CHOMPI-Club/CHOMPI/hardware/hardware-enclosure/README.md

# CHOMPI — Enclosure Panels

The six PCB files for **CHOMPI**'s enclosure panels — plus laser cutting files if you want to
create your own enclosure boards from alternative materials (wood, acrylic, etc.).

---

## What's in the folder

```
CC_Chompi_Rev4_Enc_TOP.brd
CC_Chompi_Rev4_Enc_BOT.brd
CC_Chompi_Rev4_Enc_FRONT.brd
CC_Chompi_Rev4_Enc_BACK.brd
CC_Chompi_Rev4_Enc_LEFT.brd
CC_Chompi_Rev4_Enc_RIGHT.brd
dxf/ each panel's outline and holes, formatted for a laser cutter
```

The `.brd` files are **EAGLE 9.6.2** and contain the outline, the holes, and a plain
copper fill on each side (with graphics removed). They are intended for use with the Rev4 main boards, 
and should be ordered as bare boards with no electrical assembly.

## What's not included

**The panel artwork.** The graphic set and CHOMPI logos have been removed for copyright
purposes, and the panel fabrication files aren't included. If you make your own panels,
we ask that you create new artwork and name your instrument something else to avoid
trademark infringement.

## Support Guidelines

This is a discontinuation open-source release. As such, this repo is intended to be a permanent
source for files and documentation, and will likely not be receiving updates in the future. If you wish
to customize your own project, we recommend cloning this repo into your own GitHub.

## Community

Even though this version of CHOMPI is now discontinued, the CLUB is expanding. If you want to
discuss this project, share your creations, see what other users have made on their CHOMPI, feel
free to check out the CHOMPI Open Source channel on the Chase Bliss Discord.

## License

MIT — see [`LICENSE`](../../LICENSE) at the root of this repo. [`THIRD_PARTY.md`](../../THIRD_PARTY.md)
lists the work this builds on. The CHOMPI name and marks are not covered by the license — see
[`TRADEMARKS.md`](../../TRADEMARKS.md).
