CHOMPI-Club/CHOMPI/firmware/chompi-tape/code/Chompi_Bootloader/bootloader/README.md

# bootloader

## Author

<!-- Insert Your Name Here -->

## Description

<!-- Describe your example here -->
