CHOMPI-Club/CHOMPI/hardware/hardware-enclosure/dxf/CC_Chompi_Rev4_Enc_BACK.dxf

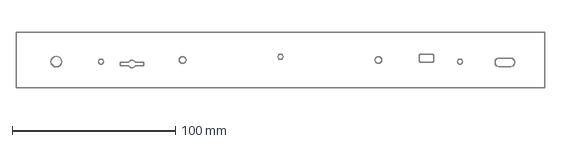
[picture p2: CAD file, 2026-09-29]
hardware/hardware-enclosure/dxf/CC_Chompi_Rev4_Enc_BACK.dxf
324.0 x 34.2 mm
