CHOMPI-Club/CHOMPI/hardware/hardware-enclosure/dxf/CC_Chompi_Rev4_Enc_LEFT.dxf

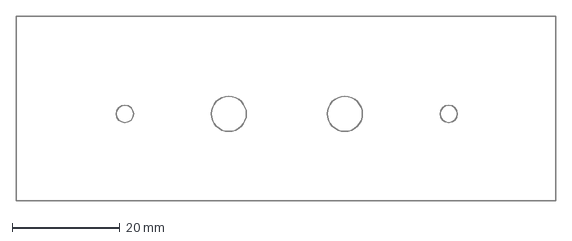
[picture p3: CAD file, 2026-09-29]
hardware/hardware-enclosure/dxf/CC_Chompi_Rev4_Enc_LEFT.dxf
100.0 x 34.2 mm
