CHOMPI-Club/CHOMPI/hardware/hardware-enclosure/dxf/CC_Chompi_Rev4_Enc_TOP.dxf

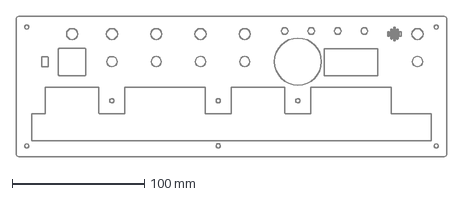
[picture p4: CAD file, 2026-09-29]
hardware/hardware-enclosure/dxf/CC_Chompi_Rev4_Enc_TOP.dxf
326.0 x 106.0 mm
