CHOMPI-Club/CHOMPI/hardware/hardware-enclosure/dxf/CC_Chompi_Rev4_Enc_FRONT.dxf

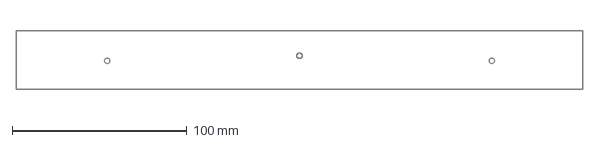
[picture p5: CAD file, 2026-09-29]
hardware/hardware-enclosure/dxf/CC_Chompi_Rev4_Enc_FRONT.dxf
324.0 x 33.2 mm
