CHOMPI-Club/CHOMPI/hardware/hardware-pcb/CHOMPI_Rev4_Schematic.pdf

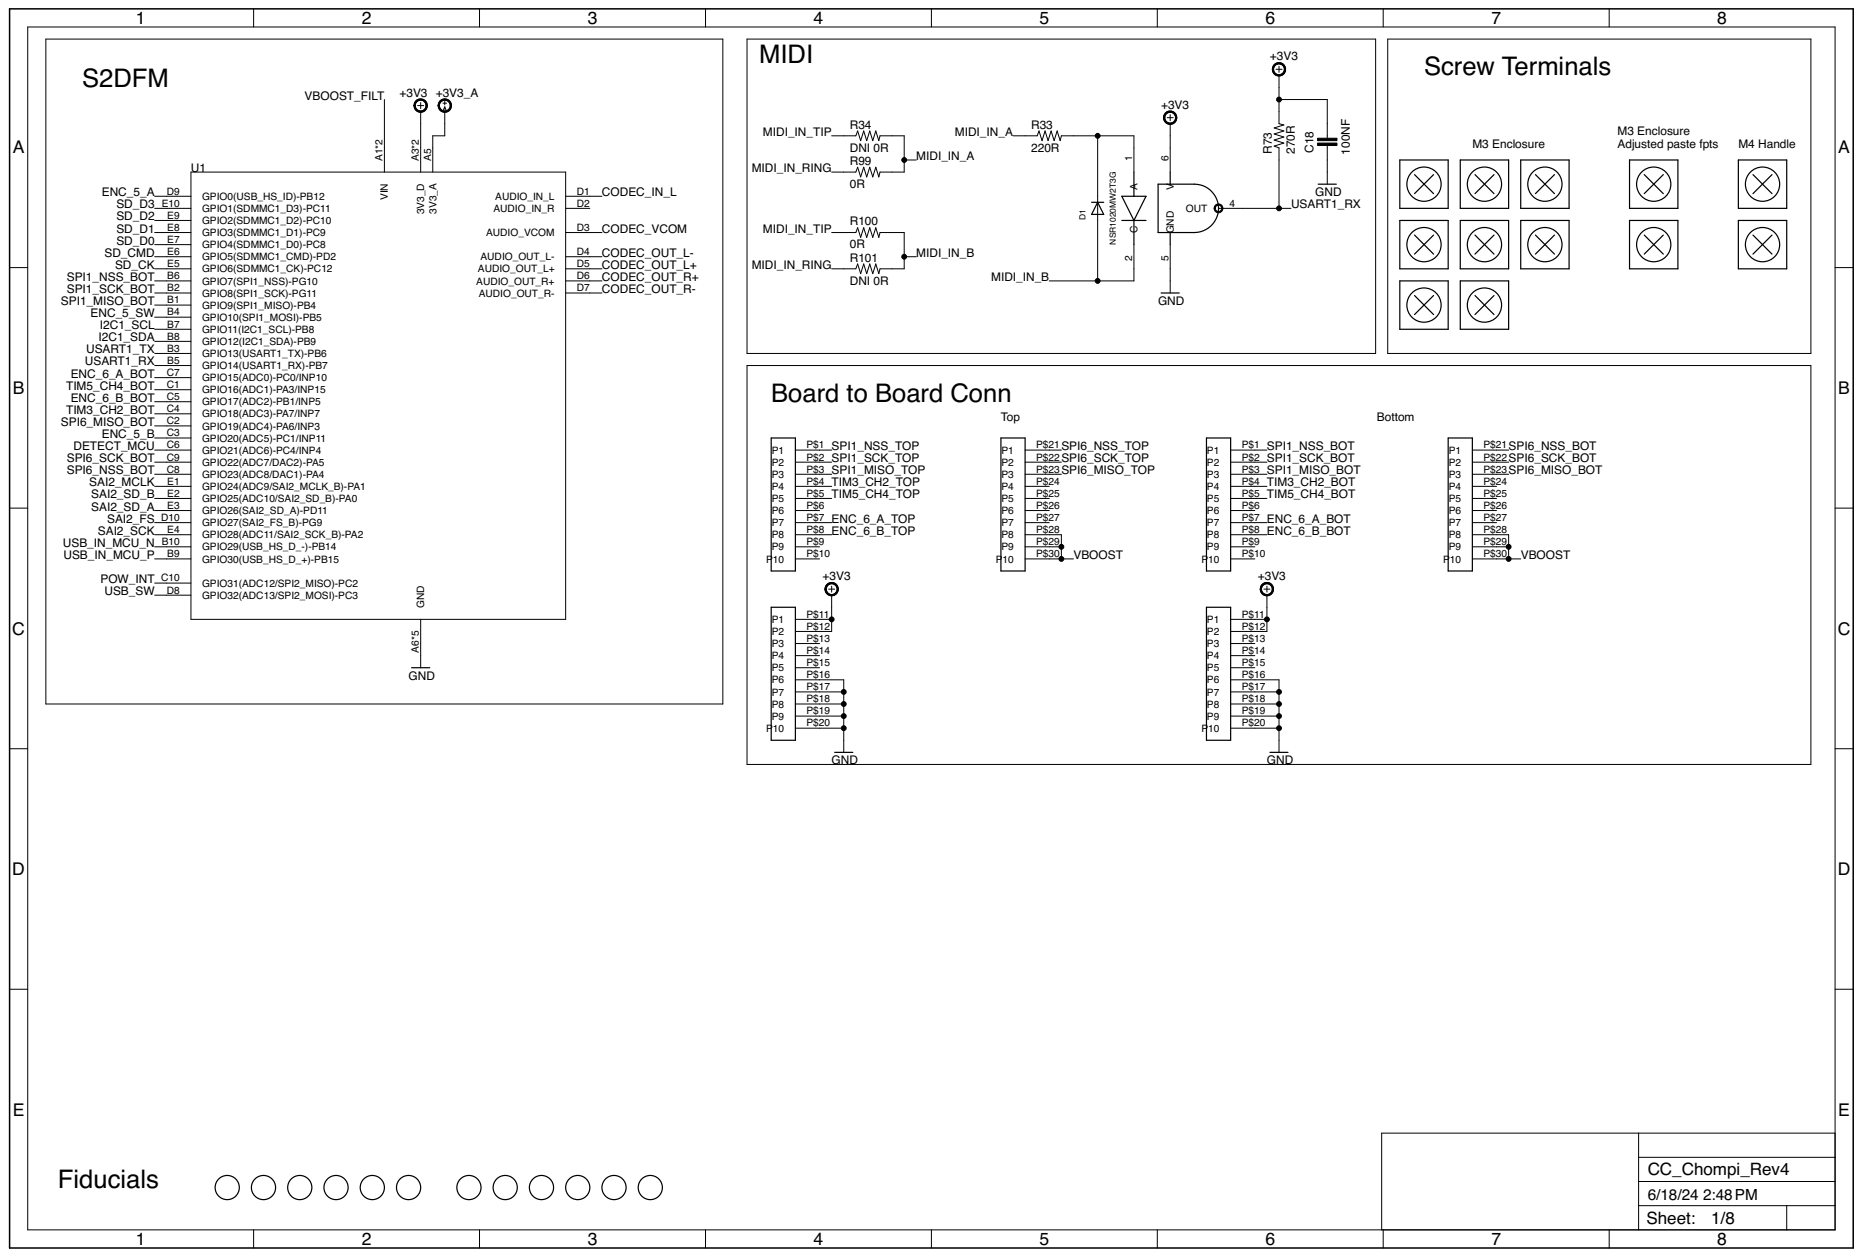
[picture p7: page 1]

Board to Board Conn

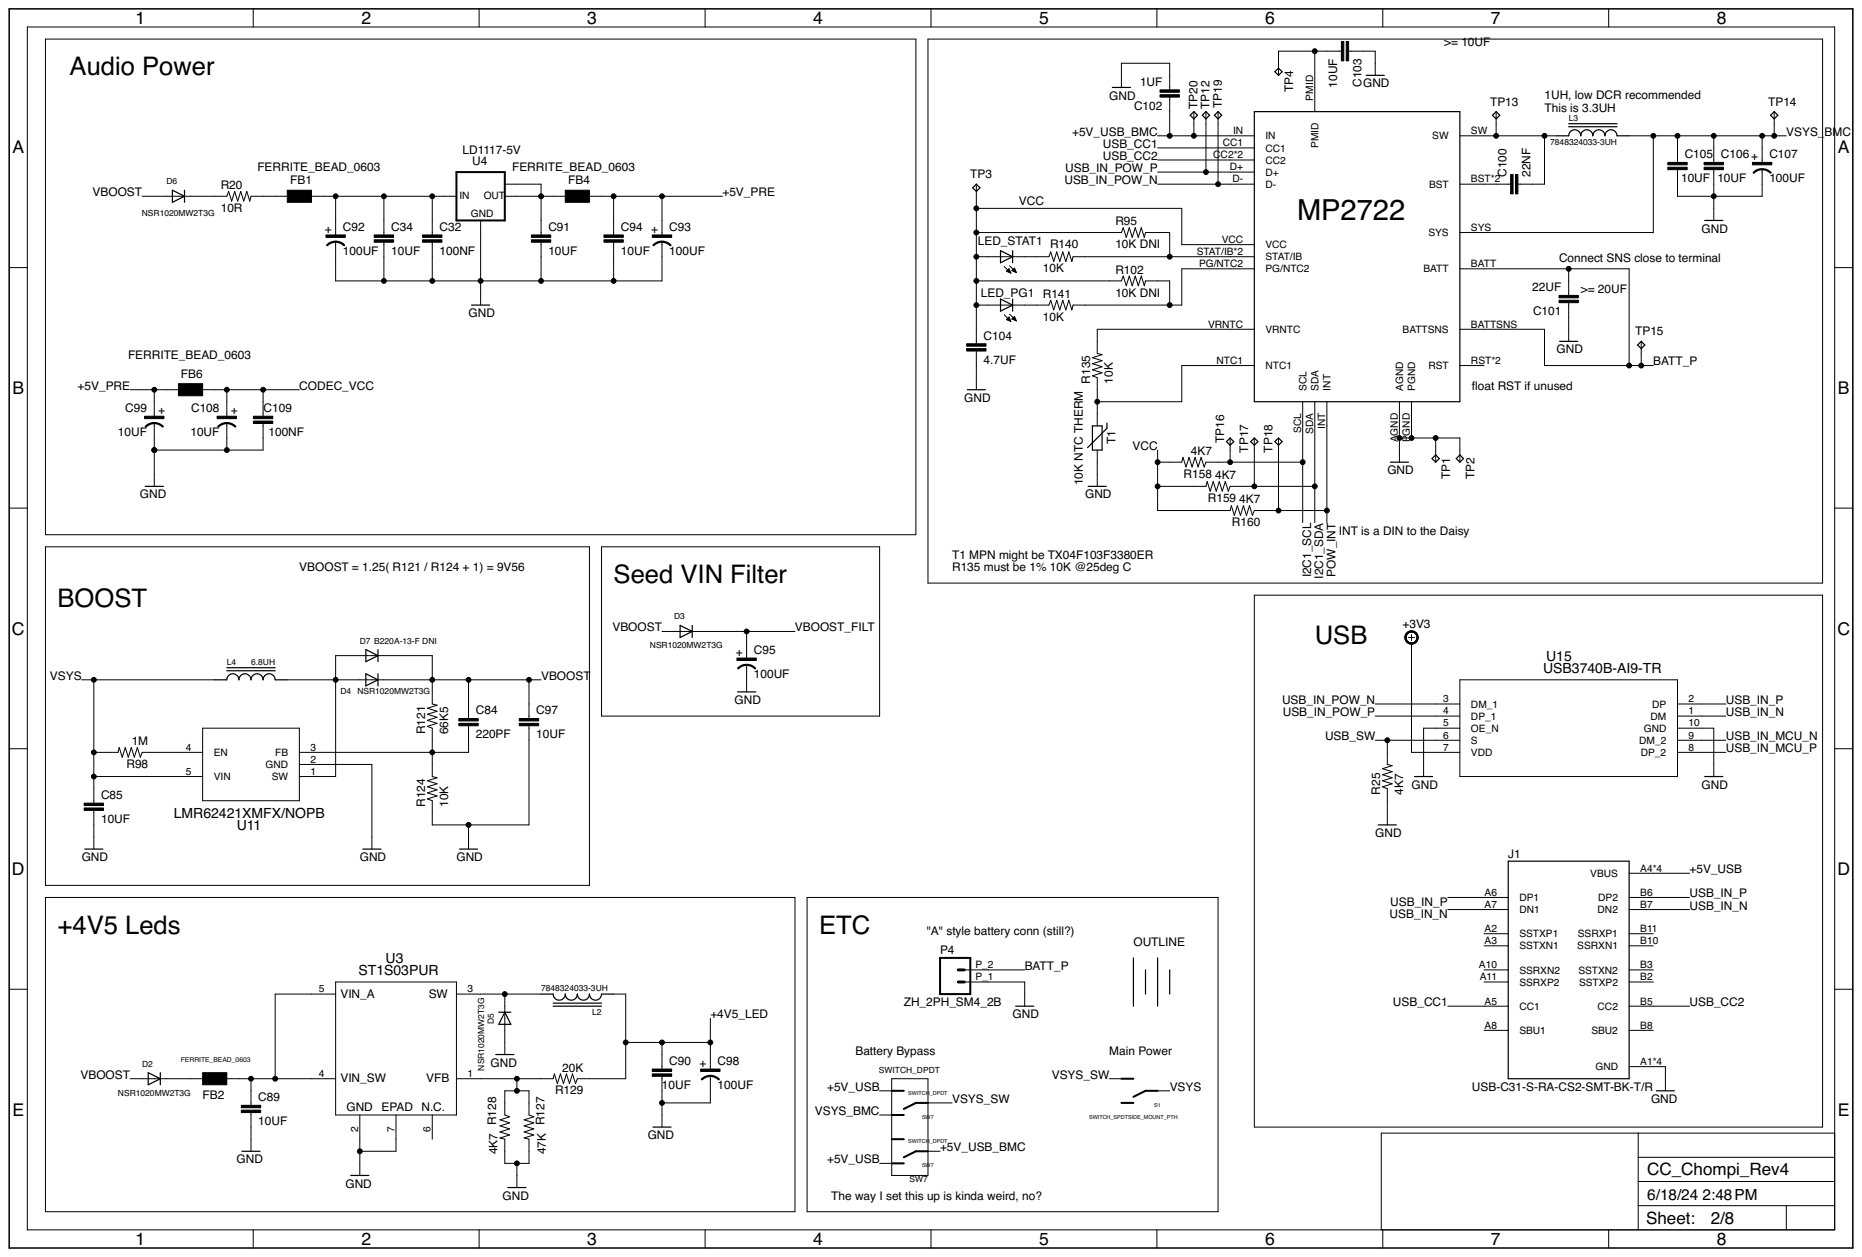
[picture p8: page 2]

Connect SNS close to terminal >= 20UF

float RST if unused

I2C1_SDA
INT is a DIN to the Daisy

"A" style battery conn (still?)

USB-C31-S-RA-CS2-SMT-BK-T/R

The way I set this up is kinda weird, no?

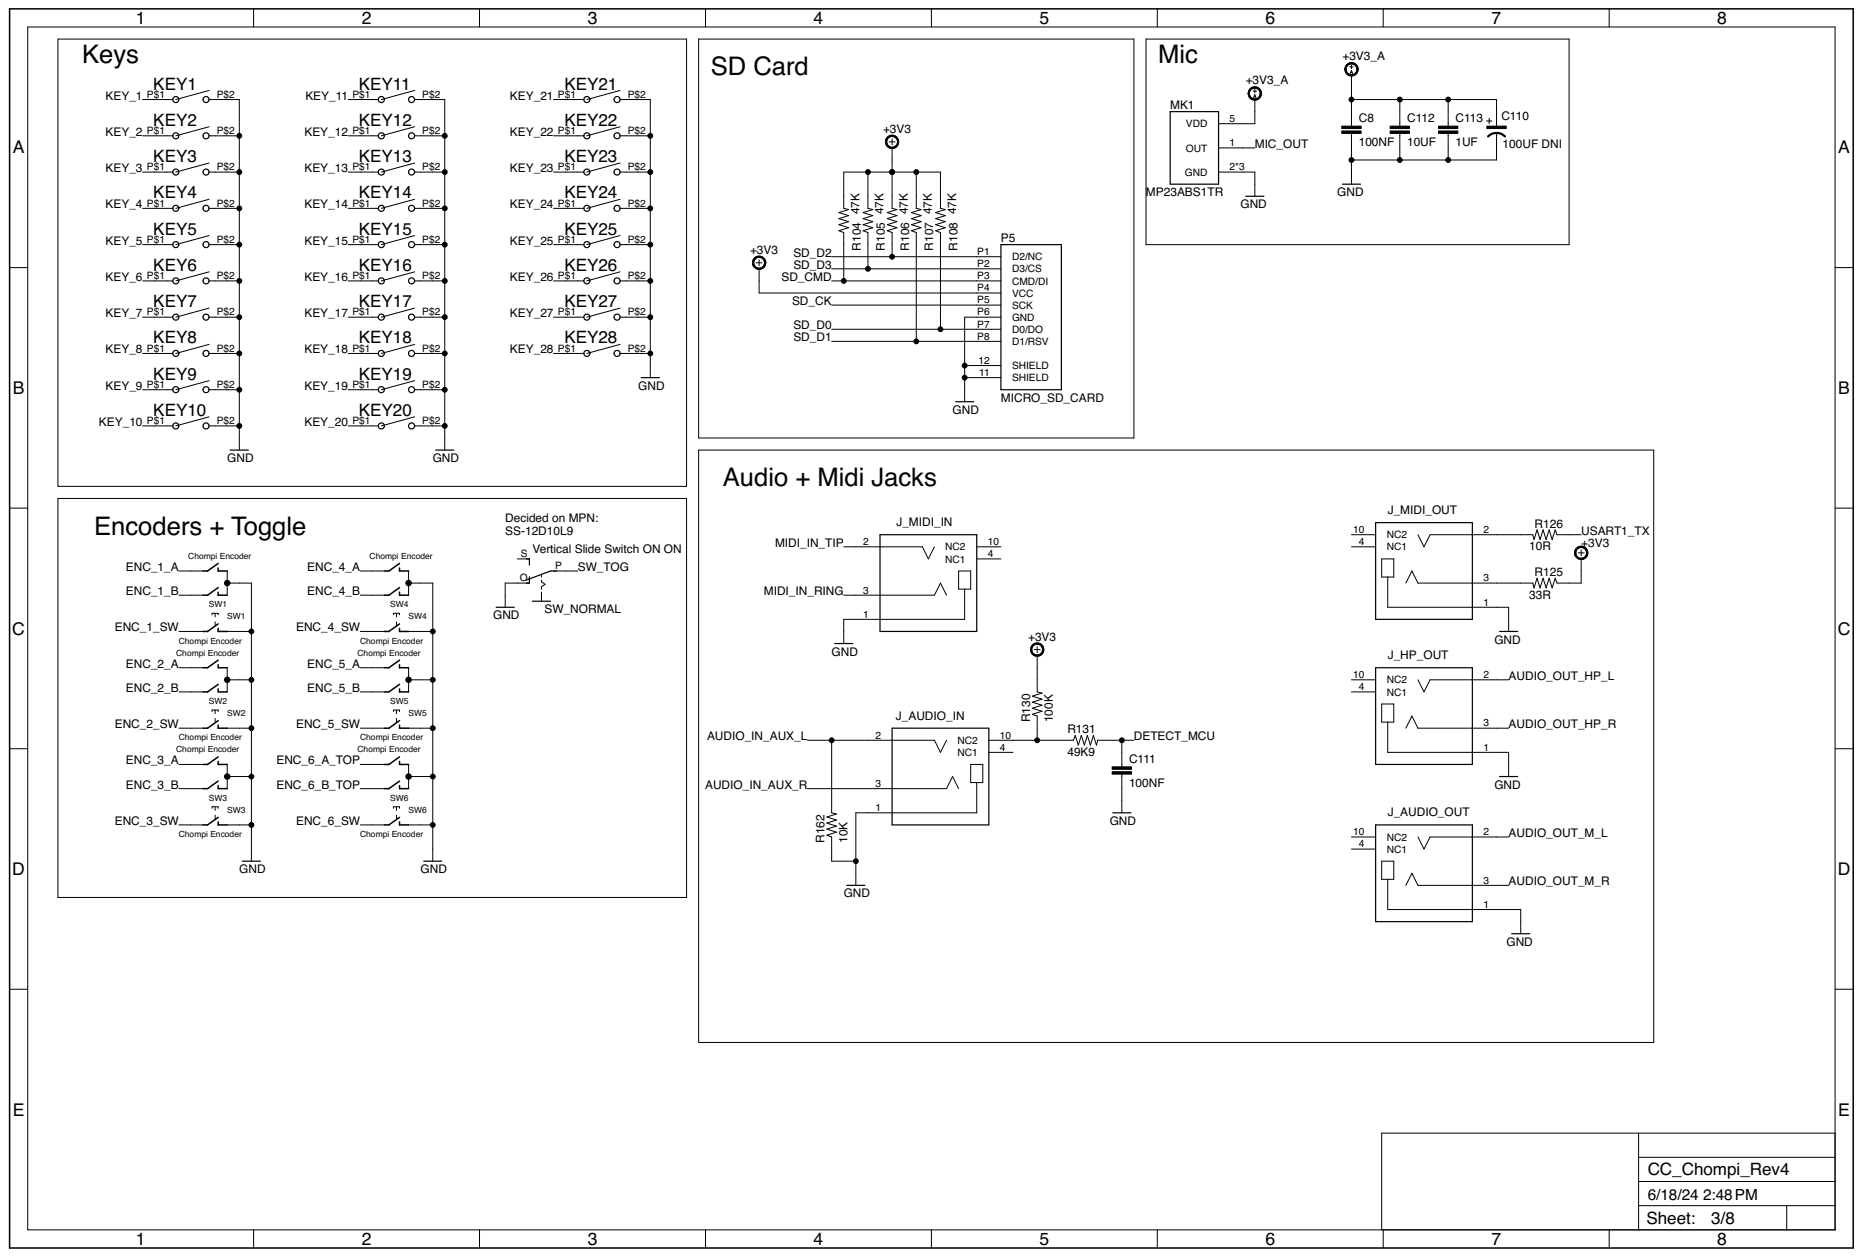
[picture p9: page 3]

Decided on MPN: SS-12D10L9

Vertical Slide Switch ON ON

Chompi Encoder

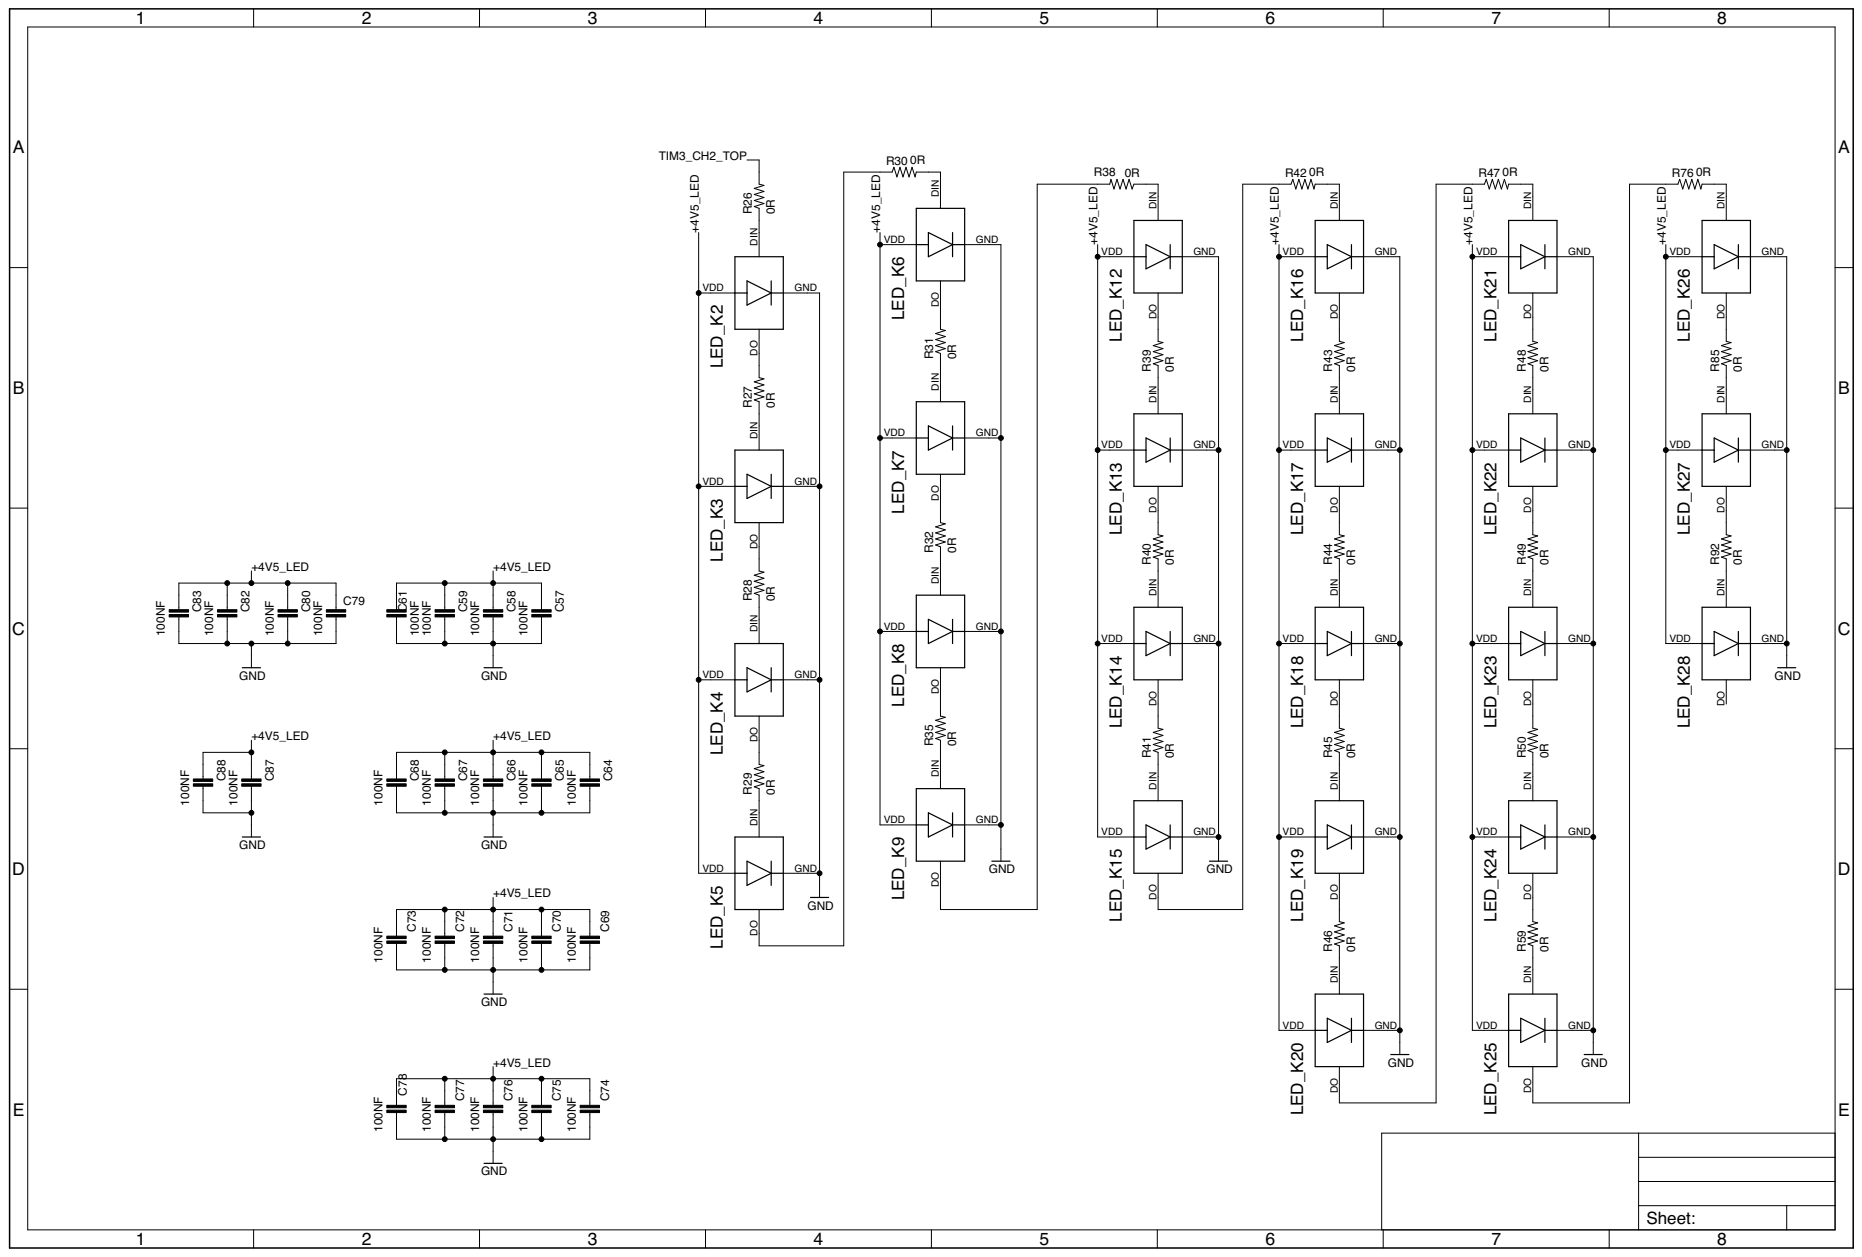
[picture p10: page 4]

LED_K2 LED_K4 LED_K5 LED_K3 GND 0R 0R 0R 0R LED_K6 LED_K7 LED_K8 LED_K9 GND 0R 0R 0R 0R LED_K12 LED_K13 LED_K14 LED_K15 GND 0R 0R 0R 0R LED_K16 LED_K17 LED_K18 LED_K19 LED_K20 GND 0R 0R 0R 0R 0R LED_K21 LED_K22 LED_K23 LED_K24 LED_K25 GND 0R 0R 0R 0R 0R LED_K26 LED_K27 LED_K28 GND 0R 0R 0R 100NF 100NF 100NF 100NF GND 100NF 100NF 100NF 100NF 100NF GND 100NF 100NF 100NF 100NF 100NF GND 100NF 100NF 100NF 100NF 100NF GND 100NF 100NF 100NF 100NF GND 100NF 100NF GND DIN DO VDD GND DIN DO VDD GND DIN DO VDD GND DIN DO VDD GND R26 R27 R28 R29 DIN DO VDD GND DIN DO VDD GND DIN DO VDD GND DIN DO VDD GND R30 R31 R32 R35 DIN DO VDD GND DIN DO VDD GND DIN DO VDD GND DIN DO VDD GND R38 R39 R40 R41 DIN DO VDD GND DIN DO VDD GND DIN DO VDD GND DIN DO VDD GND DIN DO VDD GND R42 R43 R44 R45 R46 DIN DO VDD GND DIN DO VDD GND DIN DO VDD GND DIN DO VDD GND DIN DO VDD GND R47 R48 R49 R50 R59 DIN DO VDD GND DIN DO VDD GND DIN DO VDD GND R76 R85 R92 C57 C58 C59 C61 C64 C65 C66 C67 C68 C69 C70 C71 C72 C73 C74 C75 C76 C77 C78 C79 C80 C82 C83 C87 C88 +4V5_LED +4V5_LED +4V5_LED +4V5_LED +4V5_LED +4V5_LED +4V5_LED +4V5_LED +4V5_LED +4V5_LED +4V5_LED +4V5_LED TIM3_CH2_TOP Sheet: ABCDE 1 2 3 4 5 6 7 8 ABCDE 1 2 3 4 5 6 7 8

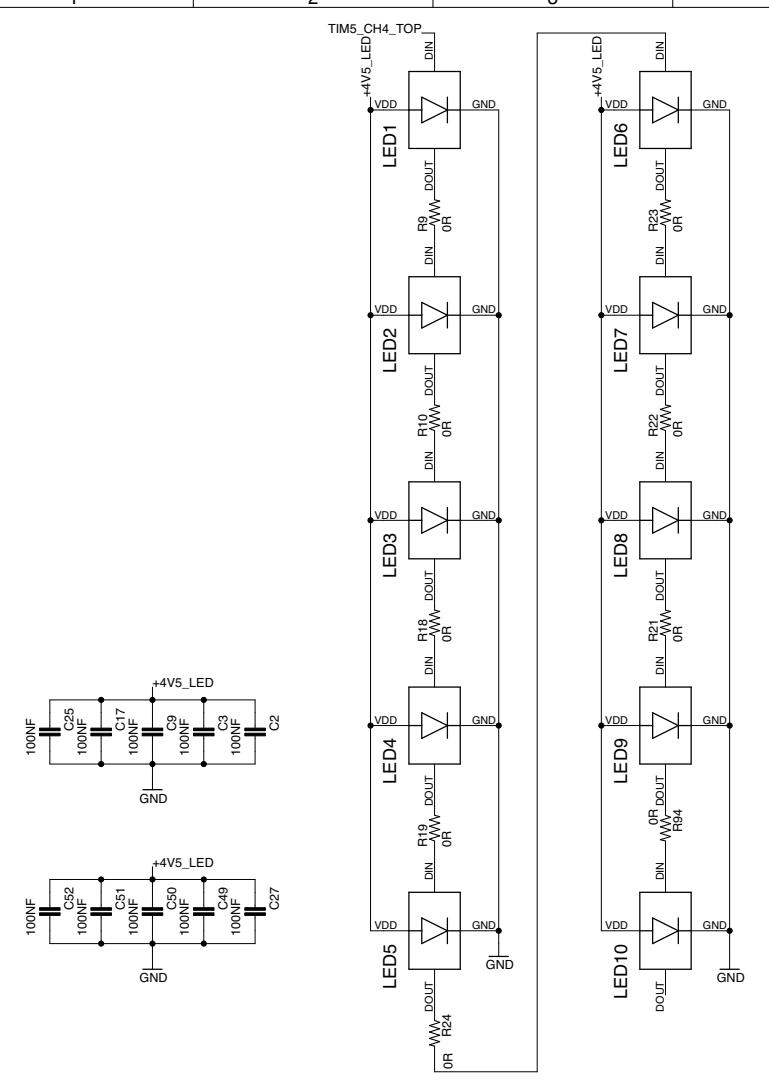
[picture p11: page 5]

LED1 LED2 LED3 LED4 LED5 LED6 LED7 LED8 LED9 LED10 GND 0R 0R 0R 0R 0R 0R 0R 0R 100NF 100NF 100NF 100NF 100NF GND 100NF 100NF 100NF 100NF 100NF GND 0R GND DIN DOUT VDD GND DIN DOUT VDD GND DIN DOUT VDD GND DIN DOUT VDD GND DIN DOUT VDD GND DIN DOUT VDD GND DIN DOUT VDD GND DIN DOUT VDD GND DIN DOUT VDD GND DIN DOUT VDD GND R9 R10 R18 R19 R21 R22 R23 R24 C2 C3 C9 C17 C25 C27 C49 C50 C51 C52 R94 +4V5_LED +4V5_LED +4V5_LED +4V5_LED TIM5_CH4_TOP Sheet: ABCDE 1 2 3 4 5 6 7 8 ABCDE 1 2 3 4 5 6 7 8 CC_Chompi_Rev4 6/18/24 2:48PM 5/8

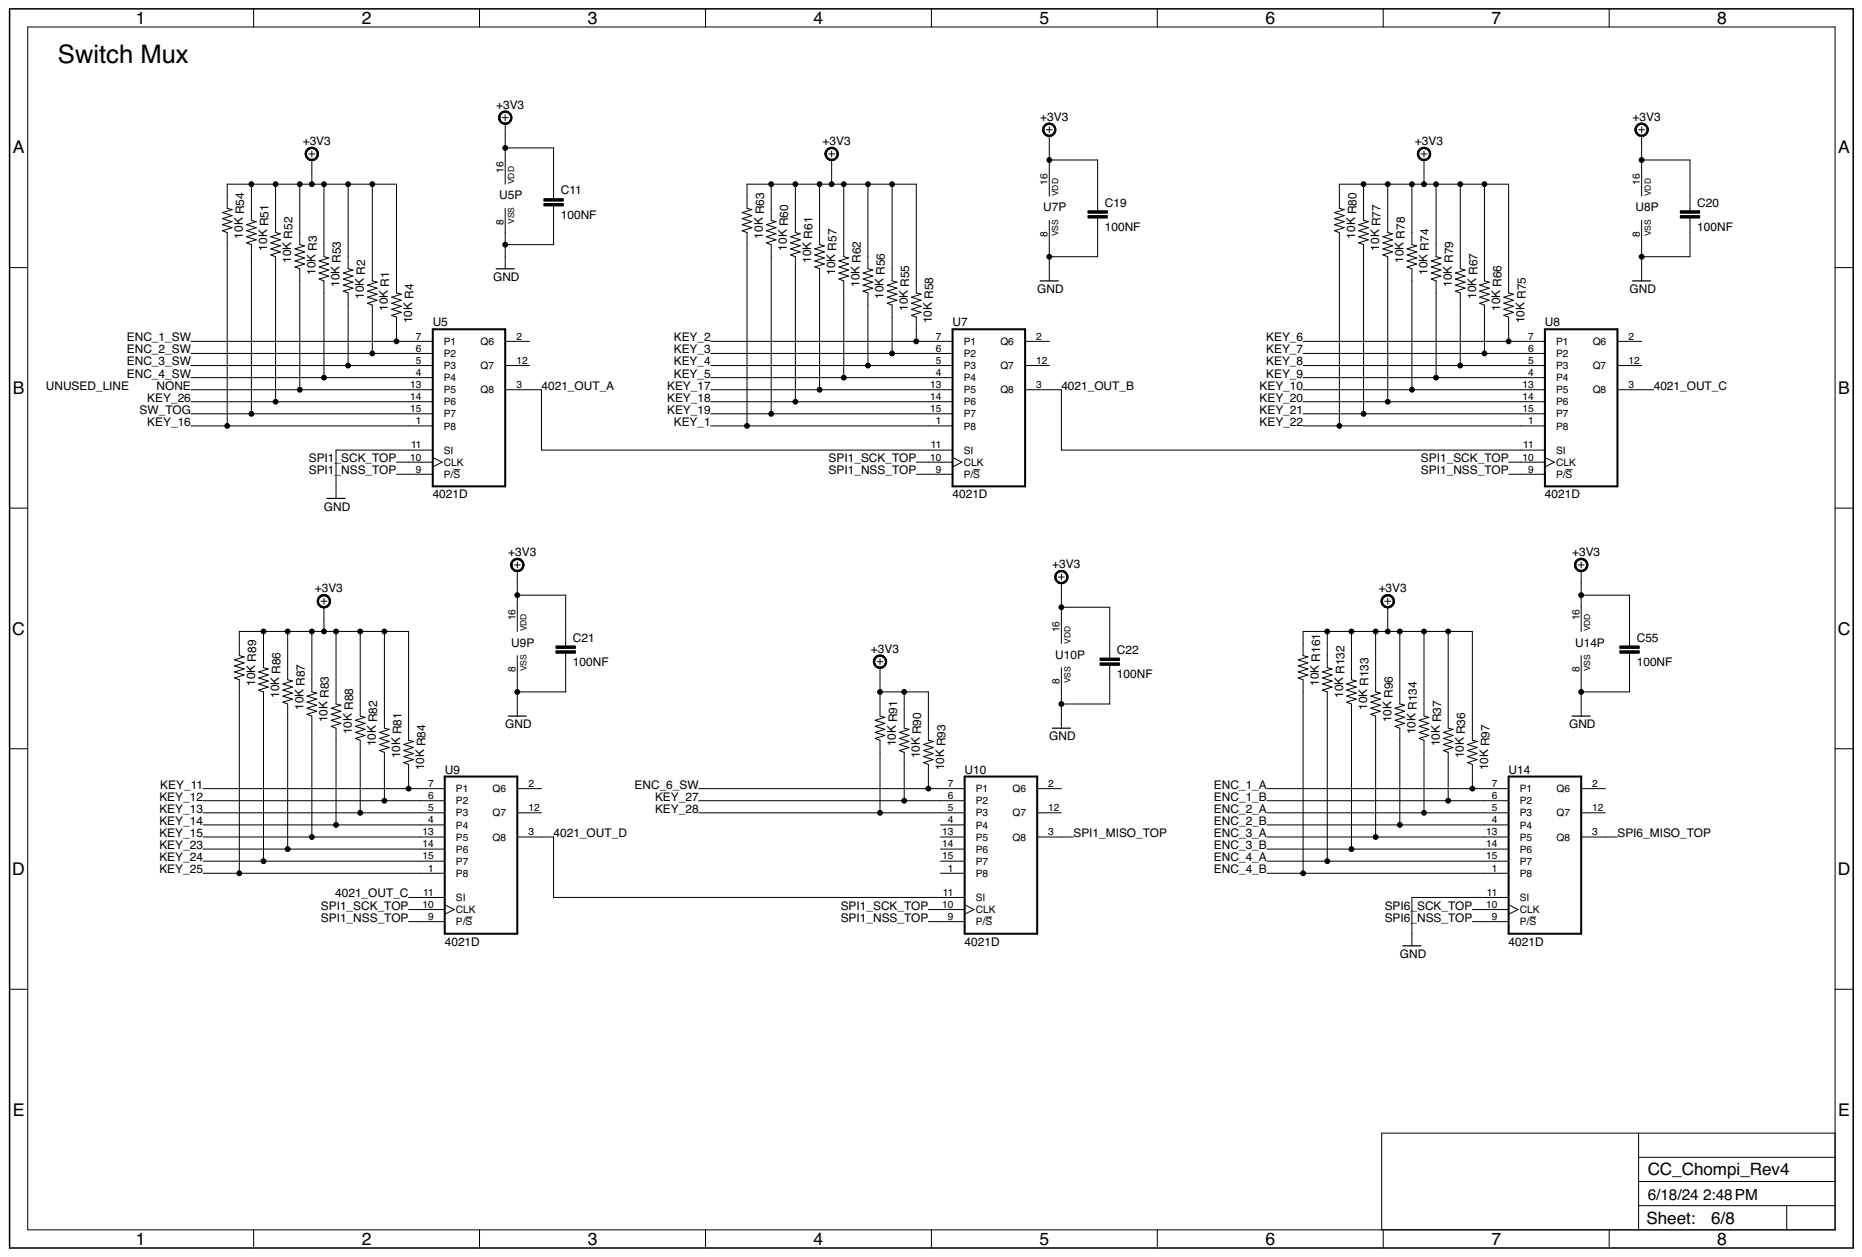
[picture p12: page 6]

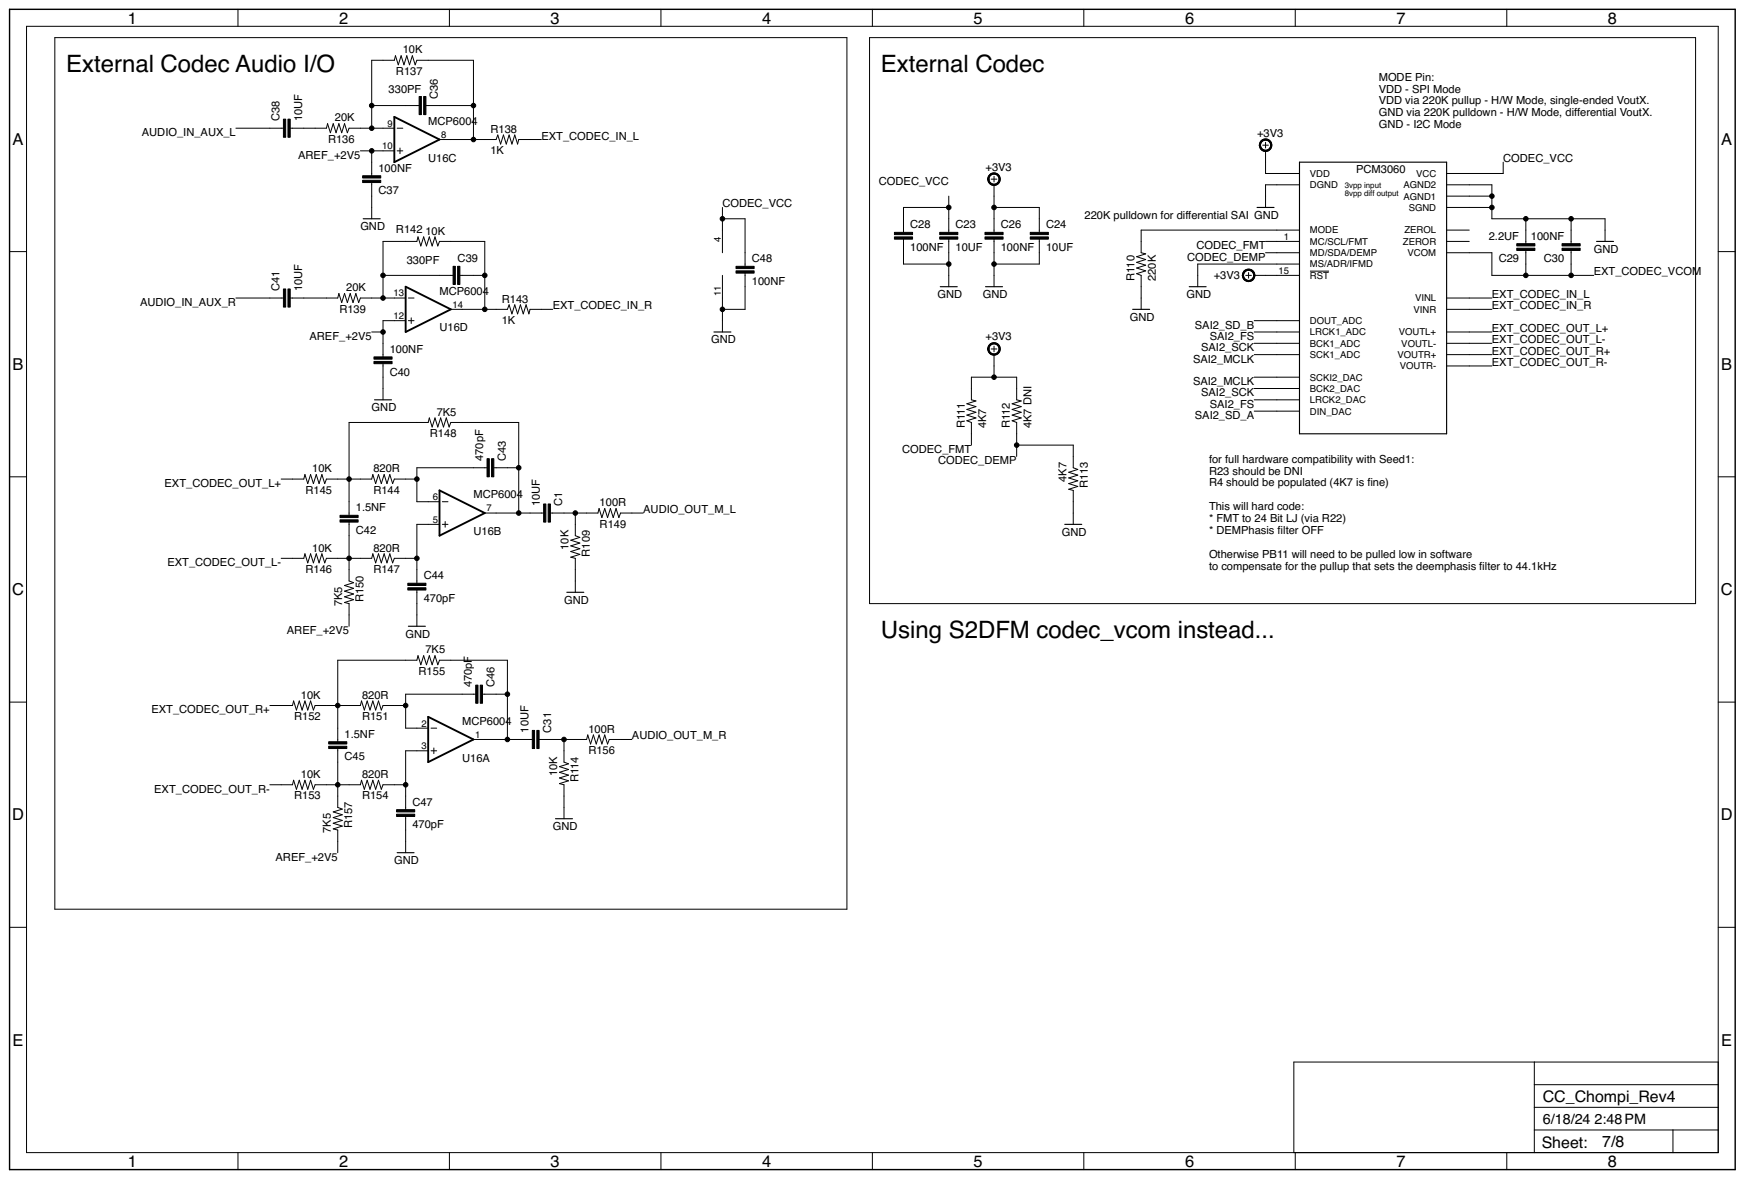
[picture p13: page 7]

MODE Pin: VDD - SPI Mode VDD via 220K pullup - H/W Mode, single-ended VoutX. GND via 220K pulldown - H/W Mode, differential VoutX. GND - I2C Mode

220K pulldown for differential SAI

VINL VINR MS/ADR/IFMD MODE R110

VOUTR- VOUTR+ VOUTL- VOUTL+

for full hardware compatibility with Seed1: R23 should be DNI

R4 should be populated (4K7 is fine)

This will hard code: * FMT to 24 Bit LJ (via R22) * DEMPhasis filter OFF

Otherwise PB11 will need to be pulled low in software
to compensate for the pullup that sets the deemphasis filter to 44.1kHz

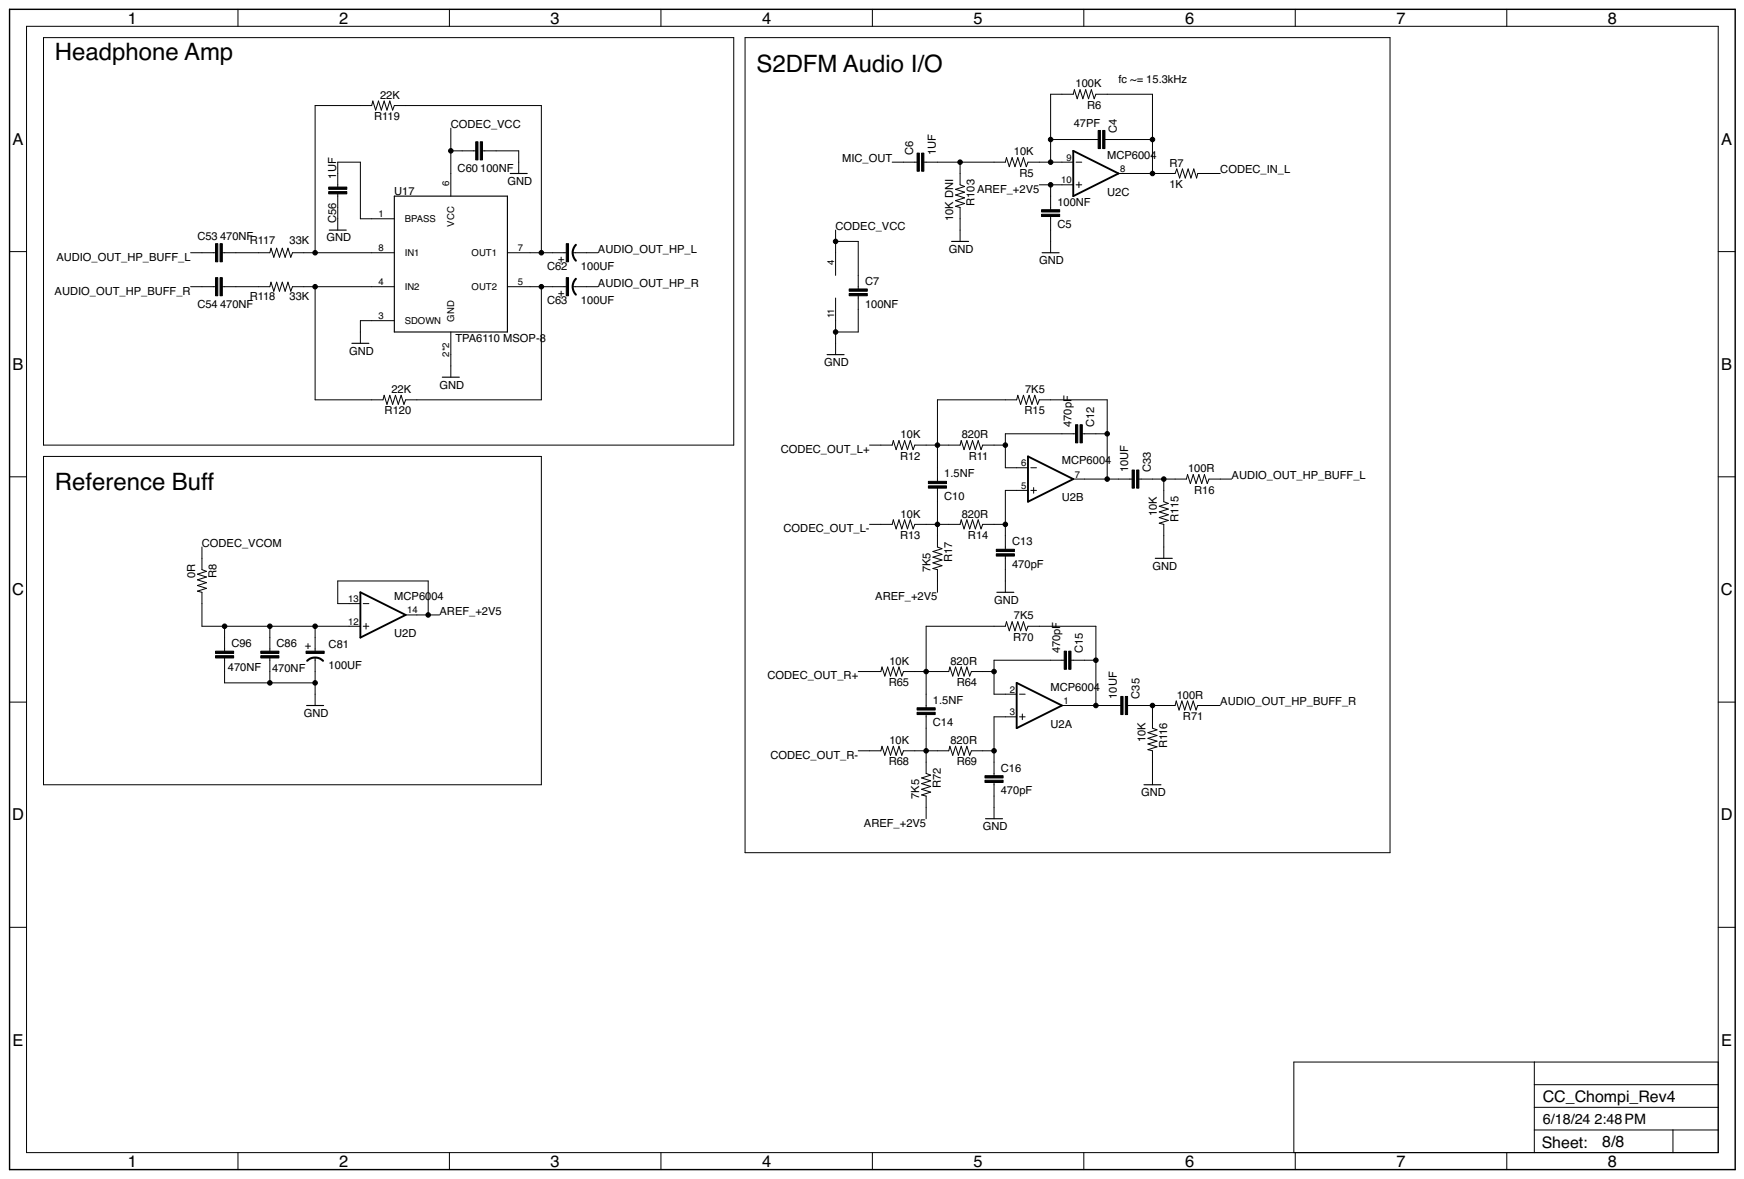
[picture p14: page 8]
