CHOMPI-Club/CHOMPI/hardware/hardware-pcb/board files/CC_Chompi_Rev4.brd

## EAGLE design hardware/hardware-pcb/board files/CC_Chompi_Rev4.brd (2026-09-29)

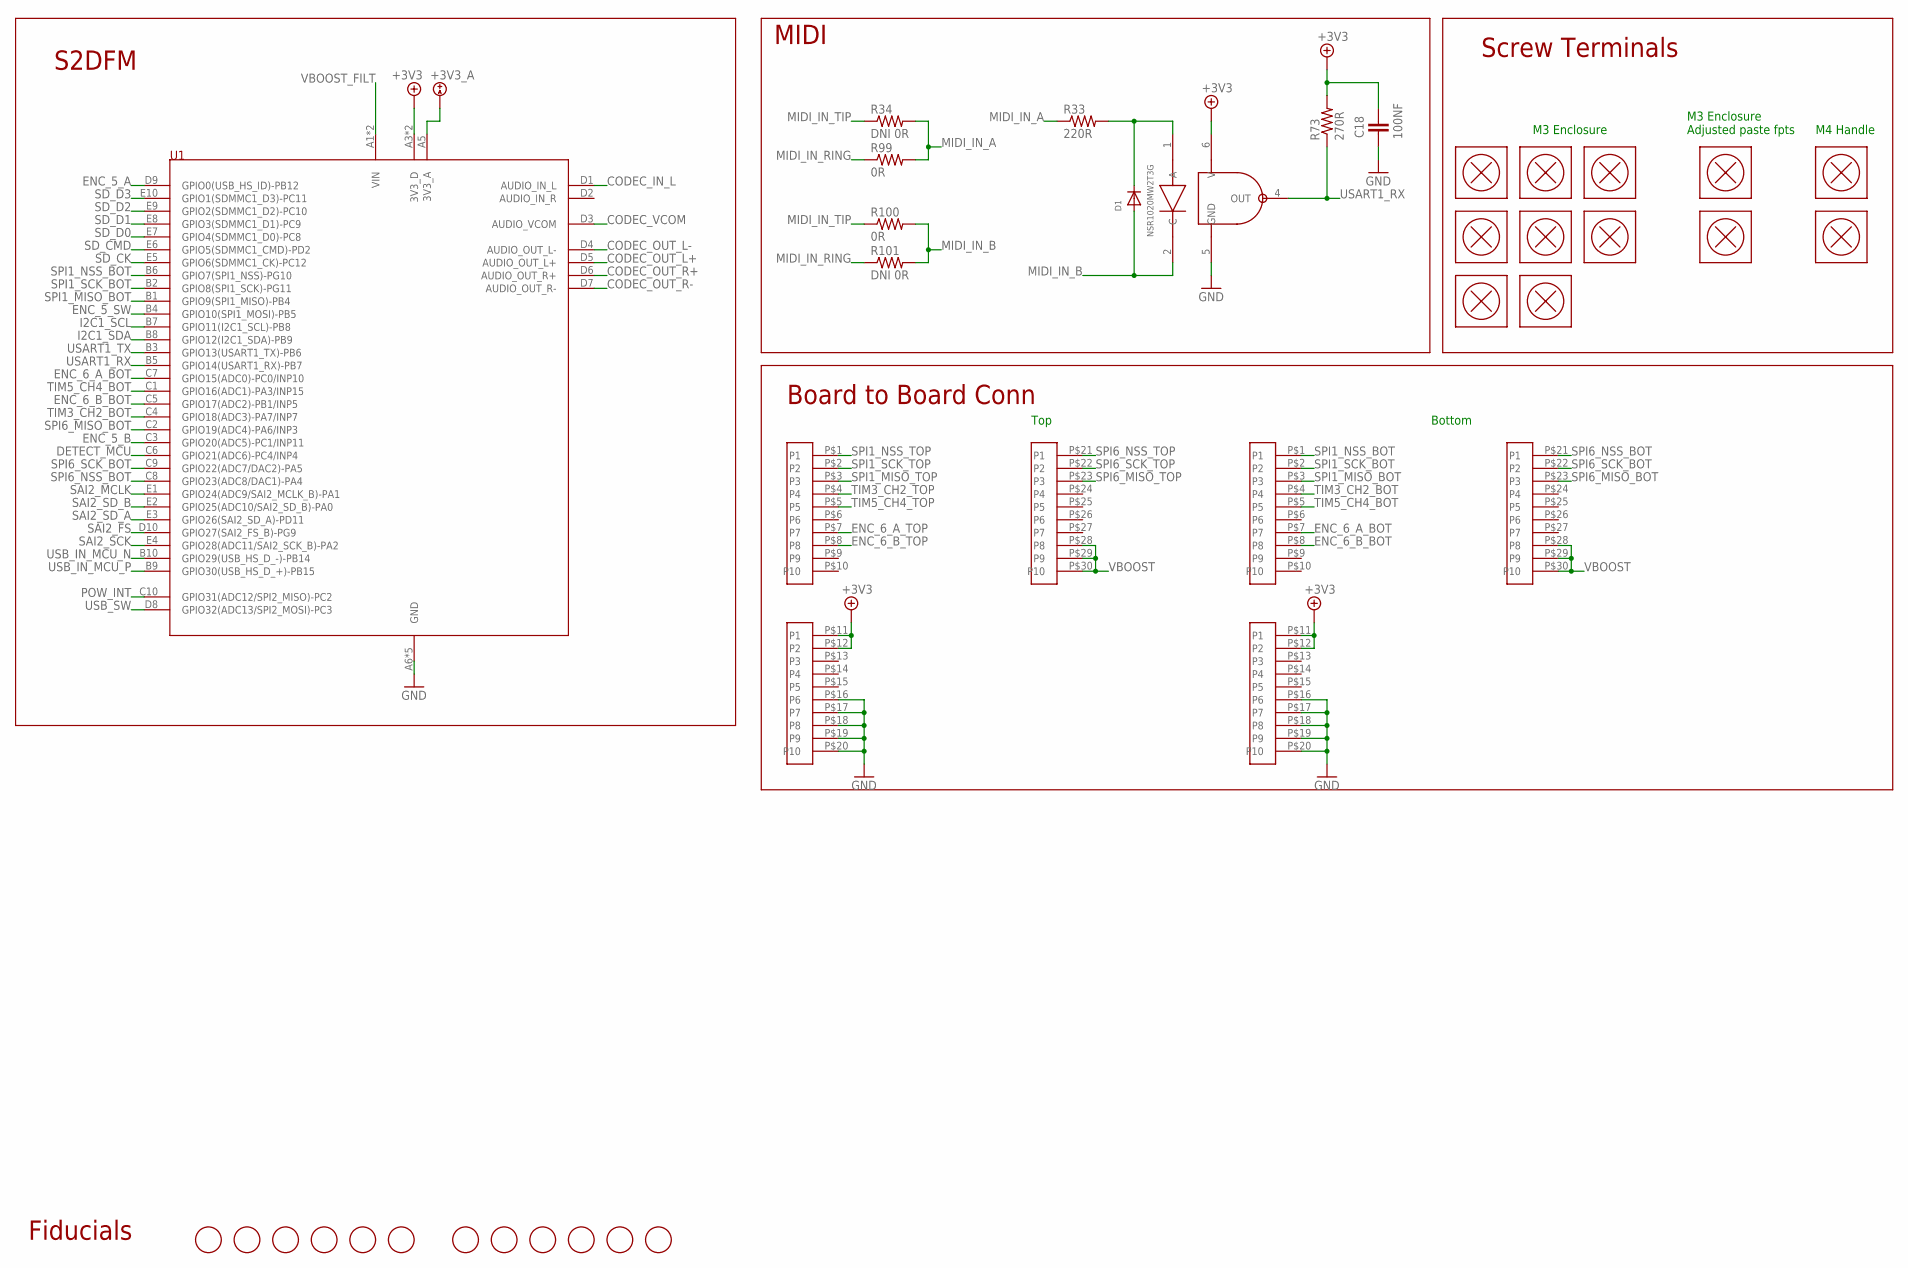
[picture p15: schematic CC_Chompi_Rev4.sch, sheet 1, MCU, etc.]

Parts:
C18: 100NF; C0402
D1: NSR1020MW2T3G; SOD-323F
FD1, FD2, FD3, FD4, FD5, FD6, FD7, FD8, FD9, FD10, FD11, FD12: FIDUCIAL; FIDUCIAL_1MM
HANDLE_1, HANDLE_2: SCREW_TERMINALM4; M4_SCREW_TERMINAL
P2, P3: ZIF-30; FH34SRJ-30S-0-5SH-50
R33: 220R; R0603
R34, R101: DNI 0R; R0603
R73: 270R; R0603
R99, R100: 0R; R0603
SCREW_1, SCREW_2, SCREW_3, SCREW_4, SCREW_5, SCREW_7, SCREW_9, SCREW_10: SCREW_TERMINALM3_OLD; T34069_OLD
SCREW_6: SCREW_TERMINALM3_OLD_ADJ2; T34069_OLD_ADJ2
SCREW_8: SCREW_TERMINALM3_OLD_ADJ1; T34069_OLD_ADJ1
U1: ES_DAISY_SEED2_DFM_REV1""; ES_DAISY_SEED2_DFM_REV1
U6: OPTO ISOLATOR; DIL06_GULLWING

Connections:
+3V3: C18.2, P2.P$11 (P1), P2.P$12 (P2), P3.P$11 (P1), P3.P$12 (P2), R73.2, U1.A3 (3V3_D), U1.A4 (3V3_D), U6.6 (V); also elsewhere on the board
+3V3_A: U1.A5 (3V3_A); also elsewhere on the board
CODEC_IN_L: U1.D1 (AUDIO_IN_L); also elsewhere on the board
CODEC_OUT_L+: U1.D5 (AUDIO_OUT_L+); also elsewhere on the board
CODEC_OUT_L-: U1.D4 (AUDIO_OUT_L-); also elsewhere on the board
CODEC_OUT_R+: U1.D6 (AUDIO_OUT_R+); also elsewhere on the board
CODEC_OUT_R-: U1.D7 (AUDIO_OUT_R-); also elsewhere on the board
CODEC_VCOM: U1.D3 (AUDIO_VCOM); also elsewhere on the board
DETECT_MCU: U1.C6 (GPIO21(ADC6)-PC4/INP4); also elsewhere on the board
ENC_5_A: U1.D9 (GPIO0(USB_HS_ID)-PB12); also elsewhere on the board
ENC_5_B: U1.C3 (GPIO20(ADC5)-PC1/INP11); also elsewhere on the board
ENC_5_SW: U1.B4 (GPIO10(SPI1_MOSI)-PB5); also elsewhere on the board
ENC_6_A_BOT: P3.P$7 (P7), U1.C7 (GPIO15(ADC0)-PC0/INP10)
ENC_6_A_TOP: P2.P$7 (P7); also elsewhere on the board
ENC_6_B_BOT: P3.P$8 (P8), U1.C5 (GPIO17(ADC2)-PB1/INP5)
ENC_6_B_TOP: P2.P$8 (P8); also elsewhere on the board
GND: C18.1, P2.P$16 (P6), P2.P$17 (P7), P2.P$18 (P8), P2.P$19 (P9), P2.P$20 (P10), P3.P$16 (P6), P3.P$17 (P7), P3.P$18 (P8), P3.P$19 (P9), P3.P$20 (P10), U1.A6 (GND), U1.A7 (GND), U1.A8 (GND), U1.A9 (GND), U1.A10 (GND), U6.5 (GND); also elsewhere on the board
I2C1_SCL: U1.B7 (GPIO11(I2C1_SCL)-PB8); also elsewhere on the board
I2C1_SDA: U1.B8 (GPIO12(I2C1_SDA)-PB9); also elsewhere on the board
MIDI_IN_A: R33.1, R34.2, R99.2
MIDI_IN_B: D1.A, R100.2, R101.2, U6.2 (C)
MIDI_IN_RING: R99.1, R101.1; also elsewhere on the board
MIDI_IN_TIP: R34.1, R100.1; also elsewhere on the board
unnamed: D1.C, R33.2, U6.1 (A)
POW_INT: U1.C10 (GPIO31(ADC12/SPI2_MISO)-PC2); also elsewhere on the board
SAI2_FS: U1.D10 (GPIO27(SAI2_FS_B)-PG9); also elsewhere on the board
SAI2_MCLK: U1.E1 (GPIO24(ADC9/SAI2_MCLK_B)-PA1); also elsewhere on the board
SAI2_SCK: U1.E4 (GPIO28(ADC11/SAI2_SCK_B)-PA2); also elsewhere on the board
SAI2_SD_A: U1.E3 (GPIO26(SAI2_SD_A)-PD11); also elsewhere on the board
SAI2_SD_B: U1.E2 (GPIO25(ADC10/SAI2_SD_B)-PA0); also elsewhere on the board
SD_CK: U1.E5 (GPIO6(SDMMC1_CK)-PC12); also elsewhere on the board
SD_CMD: U1.E6 (GPIO5(SDMMC1_CMD)-PD2); also elsewhere on the board
SD_D0: U1.E7 (GPIO4(SDMMC1_D0)-PC8); also elsewhere on the board
SD_D1: U1.E8 (GPIO3(SDMMC1_D1)-PC9); also elsewhere on the board
SD_D2: U1.E9 (GPIO2(SDMMC1_D2)-PC10); also elsewhere on the board
SD_D3: U1.E10 (GPIO1(SDMMC1_D3)-PC11); also elsewhere on the board
SPI1_MISO_BOT: P3.P$3 (P3), U1.B1 (GPIO9(SPI1_MISO)-PB4)
SPI1_MISO_TOP: P2.P$3 (P3); also elsewhere on the board
SPI1_NSS_BOT: P3.P$1 (P1), U1.B6 (GPIO7(SPI1_NSS)-PG10)
SPI1_NSS_TOP: P2.P$1 (P1); also elsewhere on the board
SPI1_SCK_BOT: P3.P$2 (P2), U1.B2 (GPIO8(SPI1_SCK)-PG11)
SPI1_SCK_TOP: P2.P$2 (P2); also elsewhere on the board
SPI6_MISO_BOT: P3.P$23 (P3), U1.C2 (GPIO19(ADC4)-PA6/INP3)
SPI6_MISO_TOP: P2.P$23 (P3); also elsewhere on the board
SPI6_NSS_BOT: P3.P$21 (P1), U1.C8 (GPIO23(ADC8/DAC1)-PA4)
SPI6_NSS_TOP: P2.P$21 (P1); also elsewhere on the board
SPI6_SCK_BOT: P3.P$22 (P2), U1.C9 (GPIO22(ADC7/DAC2)-PA5)
SPI6_SCK_TOP: P2.P$22 (P2); also elsewhere on the board
TIM3_CH2_BOT: P3.P$4 (P4), U1.C4 (GPIO18(ADC3)-PA7/INP7)
TIM3_CH2_TOP: P2.P$4 (P4); also elsewhere on the board
TIM5_CH4_BOT: P3.P$5 (P5), U1.C1 (GPIO16(ADC1)-PA3/INP15)
TIM5_CH4_TOP: P2.P$5 (P5); also elsewhere on the board
USART1_RX: R73.1, U1.B5 (GPIO14(USART1_RX)-PB7), U6.4 (OUT)
USART1_TX: U1.B3 (GPIO13(USART1_TX)-PB6); also elsewhere on the board
USB_IN_MCU_N: U1.B10 (GPIO29(USB_HS_D_-)-PB14); also elsewhere on the board
USB_IN_MCU_P: U1.B9 (GPIO30(USB_HS_D_+)-PB15); also elsewhere on the board
USB_SW: U1.D8 (GPIO32(ADC13/SPI2_MOSI)-PC3); also elsewhere on the board
VBOOST: P2.P$28 (P8), P2.P$29 (P9), P2.P$30 (P10), P3.P$28 (P8), P3.P$29 (P9), P3.P$30 (P10); also elsewhere on the board
VBOOST_FILT: U1.A1 (VIN), U1.A2 (VIN); also elsewhere on the board

Notes on the sheet:
MIDI
S2DFM
Top
Bottom
M3 Enclosure
M4 Handle
Board to Board Conn
Screw Terminals
Fiducials
M3 Enclosure Adjusted paste fpts

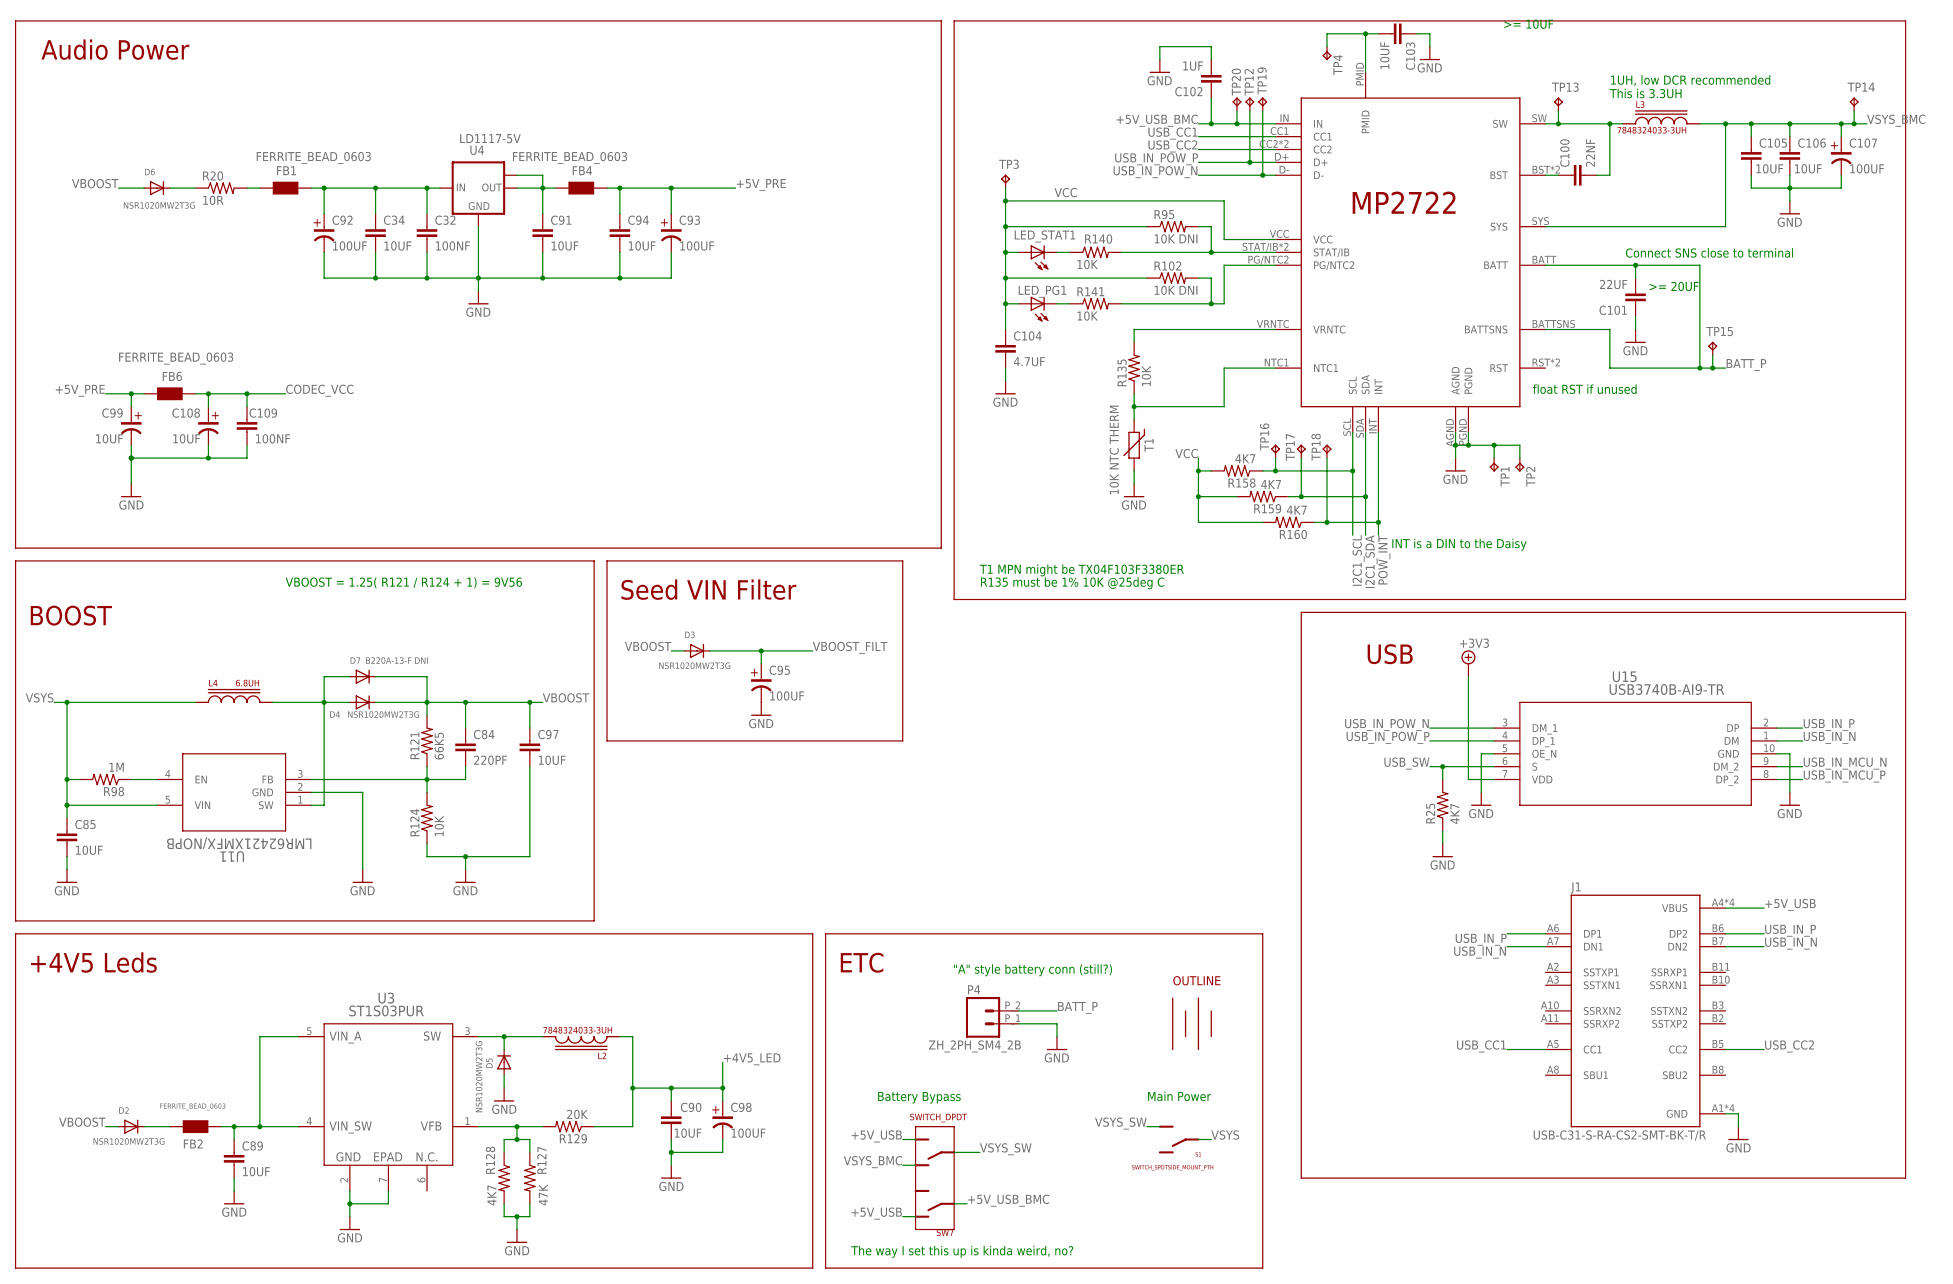
[picture p16: schematic CC_Chompi_Rev4.sch, sheet 2, Power]

Parts:
C32, C109: 100NF; C0402
C34, C85, C89, C90, C91, C94, C97, C103, C105, C106: 10UF; C0805
C84: 220PF; C0603
C92, C93, C95, C98, C107: 100UF; PANASONIC_D
C99, C108: 10UF; PANASONIC_B
C100: 22NF; C0603
C101: 22UF; C1206
C102: 1UF; C0603
C104: 4.7UF; C0603
D2, D3, D4, D5, D6: NSR1020MW2T3G; SOD-323F
D7: B220A-13-F DNI; SMADIODE
FB1, FB2, FB4, FB6: FERRITE_BEAD_0603; WUERTH-ELEKTRONIK_0603
J1: USB-C31-S-RA-CS2-SMT-BK-T/R; ADAM_USB-C31-S-RA-CS2-SMT-BK-T/R
L2, L3: 7848324033-3UH; I1008
L4: 6.8UH; MPL-SE6040
LED_PG1: LED_RED_0603; DIODE_0603
LED_STAT1: LED_RED_0603; DIODE_0603
P4: ZH_2PH_SM4_2B; S2B-PH-SM4-TB(LF)(SN)
R20: 10R; R0603
R25, R128, R158, R159, R160: 4K7; R0603
R95, R102: 10K DNI; R0603
R98: 1M; R0603
R121: 66K5; R0603
R124, R135, R140, R141: 10K; R0603
R127: 47K; R0603
R129: 20K; R0603
S1: SWITCH_SPDTSIDE_MOUNT_PTH; SK-12F17-G7
SW7: SWITCH_DPDT; MSS6-V-T/R
T1: 10K NTC THERM; R0603
TP1, TP2, TP3, TP12, TP13, TP14, TP15, TP16, TP17, TP18, TP19, TP20: TPTP20R; TP20R
TP4: TPTP13R; TP13R
U3: ST1S03PUR; DFN06_3X3_STM
U4: LD1117-5V; SOT223
U11: LMR62421XMFX/NOPB; MF05A
U13: MP2722 Buck Charger; MP2722
U15: USB3740B-AI9-TR; QFN10_1P6X2P1MC_MCH
U$1: LP346384

Connections:
+3V3: U15.7 (VDD); also elsewhere on the board
+4V5_LED: C90.1, C98.+ (POS), L2.2, R129.1; also elsewhere on the board
+5V_PRE: C93.+ (POS), C94.1, C99.+ (POS), FB4.2, FB6.2
+5V_USB: J1.A4 (VBUS), J1.A9 (VBUS), J1.B4 (VBUS), J1.B9 (VBUS), SW7.A (T1.1), SW7.F (T2.2)
+5V_USB_BMC: C102.1, SW7.B (P1), TP20.TP, U13.IN
BATT_P: C101.2, P4.P_2 (3), TP15.TP, U13.BATT, U13.BATTSNS
BATT_THERM: R135.1, T1.1, U13.NTC1
CODEC_VCC: C108.+ (POS), C109.1, FB6.1; also elsewhere on the board
GND: C32.2, C34.2, C85.2, C89.2, C90.2, C91.2, C92.- (NEG), C93.- (NEG), C94.2, C95.- (NEG), C97.2, C98.- (NEG), C99.- (NEG), C101.1, C102.2, C103.1, C104.2, C105.2, C106.2, C107.- (NEG), C108.- (NEG), C109.2, D5.A, J1.A1 (GND), J1.A12 (GND), J1.B1 (GND), J1.B12 (GND), P4.P_1 (2), R25.1, R124.1, R127.2, R128.2, T1.2, TP1.TP, TP2.TP, U3.2 (GND), U3.7 (EPAD), U4.1 (GND), U11.2 (GND), U13.AGND, U13.PGND, U15.5 (OE_N), U15.10 (GND); also elsewhere on the board
I2C1_SCL: R158.1, TP16.TP, U13.SCL; also elsewhere on the board
I2C1_SDA: R159.1, TP17.TP, U13.SDA; also elsewhere on the board
unnamed: C100.1, U13.BST, U13.BST_2 (BST)
unnamed: D2.C, FB2.1
unnamed: R135.2, U13.VRNTC
unnamed: FB1.1, R20.2
unnamed: D6.C, R20.1
unnamed: C32.1, C34.1, C92.+ (POS), FB1.2, U4.3 (IN)
unnamed: C84.2, R121.1, R124.2, U11.3 (FB)
unnamed: LED_STAT1.CATHODE (C), R140.1
unnamed: LED_PG1.CATHODE (C), R141.1
unnamed: D4.A, D7.A, L4.P$2, U11.1 (SW)
unnamed: C89.1, FB2.2, U3.4 (VIN_SW), U3.5 (VIN_A)
unnamed: R127.1, R128.1, R129.2, U3.1 (VFB)
unnamed: D5.C, L2.1, U3.3 (SW)
unnamed: R98.1, U11.4 (EN)
PG: R102.2, R141.2, U13.PG/NTC2
PMID: C103.2, TP4.TP, U13.PMID
POW_INT: R160.1, TP18.TP, U13.INT; also elsewhere on the board
STAT: R95.2, R140.2, U13.STAT/IB, U13.STAT/IB_2 (STAT/IB)
SW: C100.2, L3.2, TP13.TP, U13.SW
USB_CC1: J1.A5 (CC1), U13.CC1
USB_CC2: J1.B5 (CC2), U13.CC2, U13.CC2_2 (CC2)
USB_IN_MCU_N: U15.9 (DM_2); also elsewhere on the board
USB_IN_MCU_P: U15.8 (DP_2); also elsewhere on the board
USB_IN_N: J1.A7 (DN1), J1.B7 (DN2), U15.1 (DM)
USB_IN_P: J1.A6 (DP1), J1.B6 (DP2), U15.2 (DP)
USB_IN_POW_N: TP19.TP, U13.D-, U15.3 (DM_1)
USB_IN_POW_P: TP12.TP, U13.D+, U15.4 (DP_1)
USB_SW: R25.2, U15.6 (S); also elsewhere on the board
VBOOST: C84.1, C97.1, D2.A, D3.A, D4.C, D6.A, D7.C, R121.2; also elsewhere on the board
VBOOST_FILT: C95.+ (POS), D3.C; also elsewhere on the board
VCC: C104.1, LED_PG1.ANODE (A), LED_STAT1.ANODE (A), R95.1, R102.1, R158.2, R159.2, R160.2, TP3.TP, U13.VCC
VSYS: C85.1, L4.P$1, R98.2, S1.P$1, U11.5 (VIN)
VSYS_BMC: C105.1, C106.1, C107.+ (POS), L3.1, SW7.D (T2.1), TP14.TP, U13.SYS
VSYS_SW: S1.P$2 (T0), SW7.E (P2)
V_REG_2: C91.1, FB4.1, U4.2 (OUT), U4.TAB (OUT1)

Notes on the sheet:
BOOST
VBOOST = 1.25( R121 / R124 + 1) = 9V56
+4V5 Leds
1UH, low DCR recommended This is 3.3UH
INT is a DIN to the Daisy
float RST if unused
Connect SNS close to terminal
"A" style battery conn (still?)
USB
ETC
Seed VIN Filter
Audio Power
T1 MPN might be TX04F103F3380ER
R135 must be 1% 10K @25deg C
The way I set this up is kinda weird, no?
Battery Bypass
Main Power

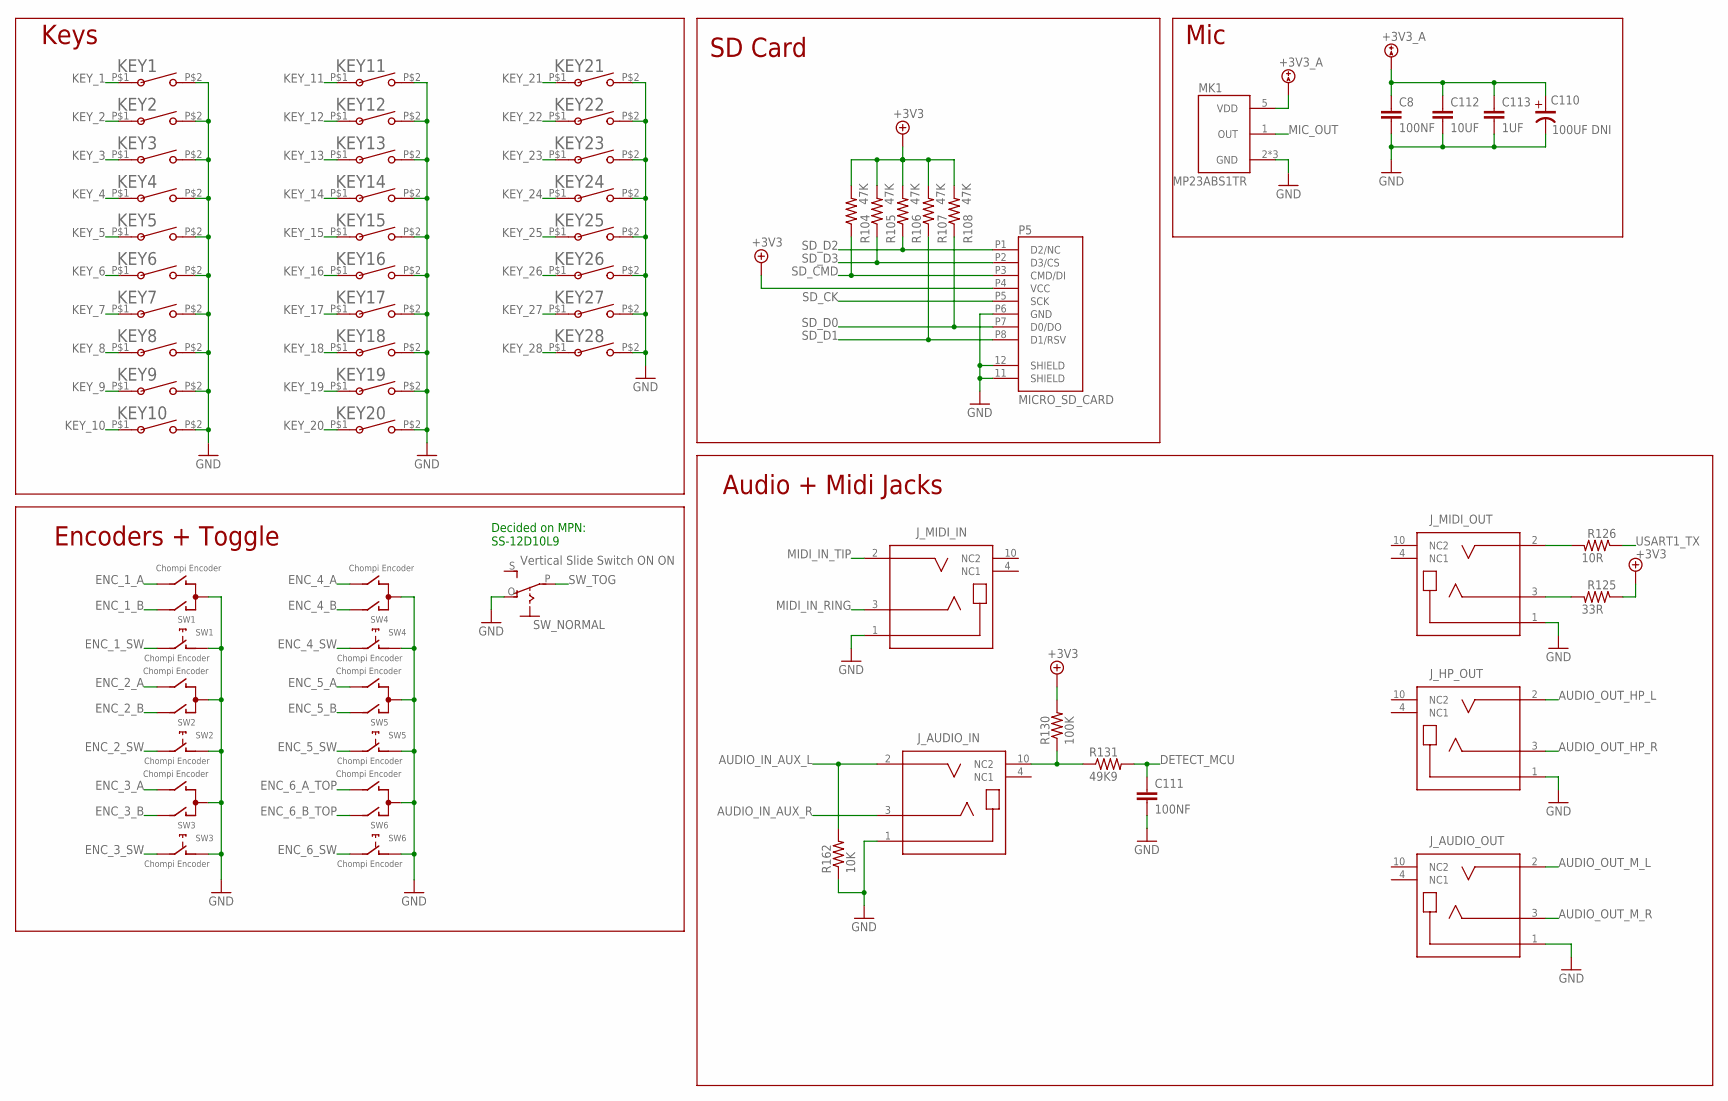
[picture p17: schematic CC_Chompi_Rev4.sch, sheet 3, Interface]

Parts:
C8, C111: 100NF; C0402
C110: 100UF DNI; PANASONIC_D
C112: 10UF; C0805
C113: 1UF; C0603
J_AUDIO_IN: PJ-3062-HD-R; CUI_SJ2-35863B1-SMT-TR
J_AUDIO_OUT: PJ-3062-HD-B; CUI_SJ2-35863B1-SMT-TR
J_HP_OUT: PJ-3062-G; CUI_SJ2-35863B1-SMT-TR
J_MIDI_IN: PJ-3062-HD-B; CUI_SJ2-35863B1-SMT-TR
J_MIDI_OUT: PJ-3062-HD-B; CUI_SJ2-35863B1-SMT-TR
KEY1, KEY2, KEY3, KEY4, KEY5, KEY6, KEY7, KEY8, KEY9, KEY10, KEY11, KEY12, KEY13, KEY14, KEY15, KEY16, KEY17, KEY18, KEY19, KEY20, KEY21, KEY22, KEY23, KEY24, KEY25, KEY26, KEY27, KEY28: MX3A-L1NB_SOCKET; CPG151101S11
MK1: MP23ABS1TR; MIC_MP23ABS1TR
P5: MICRO_SD_CARD; MEM2061-01-188-00-A_GCT
R104, R105, R106, R107, R108: 47K; R0603
R125: 33R; R0603
R126: 10R; R0603
R130: 100K; R0402
R131: 49K9; R0603
R162: 10K; R0603
SW1, SW2, SW3, SW4, SW5, SW6: Chompi Encoder; PEC11_SILK
SW_NORMAL: Vertical Slide Switch ON ON; ES_100SP1T6B11M2QEH_SMALL

Connections:
+3V3: P5.P4 (VCC), R104.2, R105.2, R106.2, R107.2, R108.2, R125.1, R130.2; also elsewhere on the board
+3V3_A: C8.1, C110.+ (POS), C112.1, C113.1, MK1.5 (VDD); also elsewhere on the board
AUDIO_IN_AUX_L: J_AUDIO_IN.2 (TIP), R162.2; also elsewhere on the board
AUDIO_IN_AUX_R: J_AUDIO_IN.3 (RING); also elsewhere on the board
AUDIO_OUT_HP_L: J_HP_OUT.2 (TIP); also elsewhere on the board
AUDIO_OUT_HP_R: J_HP_OUT.3 (RING); also elsewhere on the board
AUDIO_OUT_M_L: J_AUDIO_OUT.2 (TIP); also elsewhere on the board
AUDIO_OUT_M_R: J_AUDIO_OUT.3 (RING); also elsewhere on the board
DETECT: J_AUDIO_IN.10 (NC2), R130.1, R131.1
DETECT_MCU: C111.1, R131.2; also elsewhere on the board
ENC_1_A: SW1.B; also elsewhere on the board
ENC_1_B: SW1.A; also elsewhere on the board
ENC_1_SW: SW1.E (2); also elsewhere on the board
ENC_2_A: SW2.B; also elsewhere on the board
ENC_2_B: SW2.A; also elsewhere on the board
ENC_2_SW: SW2.E (2); also elsewhere on the board
ENC_3_A: SW3.B; also elsewhere on the board
ENC_3_B: SW3.A; also elsewhere on the board
ENC_3_SW: SW3.E (2); also elsewhere on the board
ENC_4_A: SW4.B; also elsewhere on the board
ENC_4_B: SW4.A; also elsewhere on the board
ENC_4_SW: SW4.E (2); also elsewhere on the board
ENC_5_A: SW5.B; also elsewhere on the board
ENC_5_B: SW5.A; also elsewhere on the board
ENC_5_SW: SW5.E (2); also elsewhere on the board
ENC_6_A_TOP: SW6.B; also elsewhere on the board
ENC_6_B_TOP: SW6.A; also elsewhere on the board
ENC_6_SW: SW6.E (2); also elsewhere on the board
GND: C8.2, C110.- (NEG), C111.2, C112.2, C113.2, J_AUDIO_IN.1 (SLEEVE), J_AUDIO_OUT.1 (SLEEVE), J_HP_OUT.1 (SLEEVE), J_MIDI_IN.1 (SLEEVE), J_MIDI_OUT.1 (SLEEVE), KEY1.P$2 (2), KEY2.P$2 (2), KEY3.P$2 (2), KEY4.P$2 (2), KEY5.P$2 (2), KEY6.P$2 (2), KEY7.P$2 (2), KEY8.P$2 (2), KEY9.P$2 (2), KEY10.P$2 (2), KEY11.P$2 (2), KEY12.P$2 (2), KEY13.P$2 (2), KEY14.P$2 (2), KEY15.P$2 (2), KEY16.P$2 (2), KEY17.P$2 (2), KEY18.P$2 (2), KEY19.P$2 (2), KEY20.P$2 (2), KEY21.P$2 (2), KEY22.P$2 (2), KEY23.P$2 (2), KEY24.P$2 (2), KEY25.P$2 (2), KEY26.P$2 (2), KEY27.P$2 (2), KEY28.P$2 (2), MK1.2 (GND), MK1.3 (GND), MK1.4 (GND), P5.11 (SHIELD), P5.12 (SHIELD), P5.P6 (GND), R162.1, SW1.C, SW1.D (1), SW2.C, SW2.D (1), SW3.C, SW3.D (1), SW4.C, SW4.D (1), SW5.C, SW5.D (1), SW6.C, SW6.D (1), SW_NORMAL.O; also elsewhere on the board
KEY_1: KEY1.P$1 (1); also elsewhere on the board
KEY_2: KEY2.P$1 (1); also elsewhere on the board
KEY_3: KEY3.P$1 (1); also elsewhere on the board
KEY_4: KEY4.P$1 (1); also elsewhere on the board
KEY_5: KEY5.P$1 (1); also elsewhere on the board
KEY_6: KEY6.P$1 (1); also elsewhere on the board
KEY_7: KEY7.P$1 (1); also elsewhere on the board
KEY_8: KEY8.P$1 (1); also elsewhere on the board
KEY_9: KEY9.P$1 (1); also elsewhere on the board
KEY_10: KEY10.P$1 (1); also elsewhere on the board
KEY_11: KEY11.P$1 (1); also elsewhere on the board
KEY_12: KEY12.P$1 (1); also elsewhere on the board
KEY_13: KEY13.P$1 (1); also elsewhere on the board
KEY_14: KEY14.P$1 (1); also elsewhere on the board
KEY_15: KEY15.P$1 (1); also elsewhere on the board
KEY_16: KEY16.P$1 (1); also elsewhere on the board
KEY_17: KEY17.P$1 (1); also elsewhere on the board
KEY_18: KEY18.P$1 (1); also elsewhere on the board
KEY_19: KEY19.P$1 (1); also elsewhere on the board
KEY_20: KEY20.P$1 (1); also elsewhere on the board
KEY_21: KEY21.P$1 (1); also elsewhere on the board
KEY_22: KEY22.P$1 (1); also elsewhere on the board
KEY_23: KEY23.P$1 (1); also elsewhere on the board
KEY_24: KEY24.P$1 (1); also elsewhere on the board
KEY_25: KEY25.P$1 (1); also elsewhere on the board
KEY_26: KEY26.P$1 (1); also elsewhere on the board
KEY_27: KEY27.P$1 (1); also elsewhere on the board
KEY_28: KEY28.P$1 (1); also elsewhere on the board
MIC_OUT: MK1.1 (OUT); also elsewhere on the board
MIDI_IN_RING: J_MIDI_IN.3 (RING); also elsewhere on the board
MIDI_IN_TIP: J_MIDI_IN.2 (TIP); also elsewhere on the board
unnamed: J_MIDI_OUT.3 (RING), R125.2
unnamed: J_MIDI_OUT.2 (TIP), R126.2
SD_CK: P5.P5 (SCK); also elsewhere on the board
SD_CMD: P5.P3 (CMD/DI), R104.1; also elsewhere on the board
SD_D0: P5.P7 (D0/DO), R108.1; also elsewhere on the board
SD_D1: P5.P8 (D1/RSV), R107.1; also elsewhere on the board
SD_D2: P5.P1 (D2/NC), R106.1; also elsewhere on the board
SD_D3: P5.P2 (D3/CS), R105.1; also elsewhere on the board
SW_TOG: SW_NORMAL.P; also elsewhere on the board
USART1_TX: R126.1; also elsewhere on the board

Notes on the sheet:
Keys
Encoders + Toggle
SD Card
Audio + Midi Jacks
Mic
Decided on MPN: SS-12D10L9

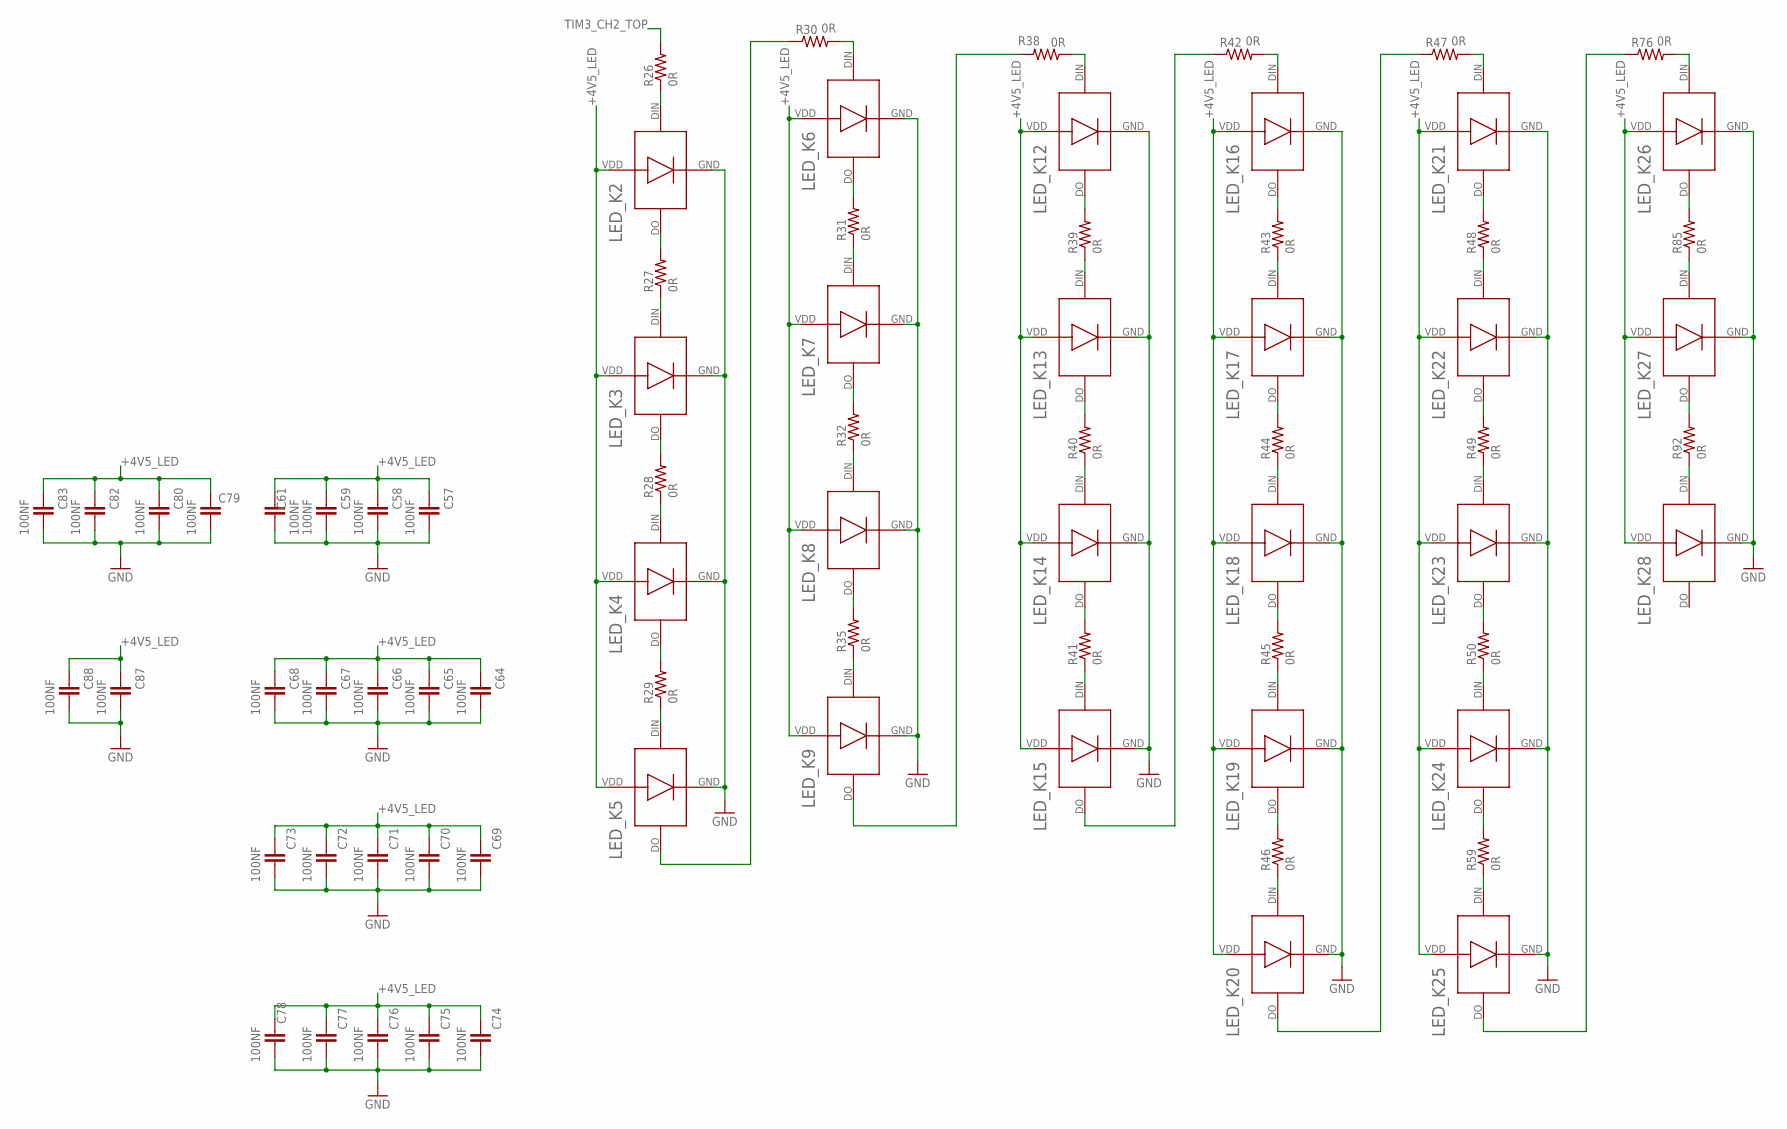
[picture p18: schematic CC_Chompi_Rev4.sch, sheet 4, Keyboard Leds]

Parts:
C57, C58, C59, C61, C64, C65, C66, C67, C68, C69, C70, C71, C72, C73, C74, C75, C76, C77, C78, C79, C80, C82, C83, C87, C88: 100NF; C0402
LED_K2, LED_K3, LED_K4, LED_K5, LED_K6, LED_K7, LED_K8, LED_K9, LED_K12, LED_K13, LED_K14, LED_K15, LED_K16, LED_K17, LED_K18, LED_K19, LED_K20, LED_K21, LED_K22, LED_K23, LED_K24, LED_K25, LED_K26, LED_K27, LED_K28: Digital LED Reverse Mount; IN-PI32TAR
R26, R27, R28, R29, R30, R31, R32, R35, R38, R39, R40, R41, R42, R43, R44, R45, R46, R47, R48, R49, R50, R59, R76, R85, R92: 0R; R0603

Connections:
+4V5_LED: C57.1, C58.1, C59.1, C61.1, C64.1, C65.1, C66.1, C67.1, C68.1, C69.1, C70.1, C71.1, C72.1, C73.1, C74.1, C75.1, C76.1, C77.1, C78.1, C79.1, C80.1, C82.1, C83.1, C87.1, C88.1, LED_K2.VDD, LED_K3.VDD, LED_K4.VDD, LED_K5.VDD, LED_K6.VDD, LED_K7.VDD, LED_K8.VDD, LED_K9.VDD, LED_K12.VDD, LED_K13.VDD, LED_K14.VDD, LED_K15.VDD, LED_K16.VDD, LED_K17.VDD, LED_K18.VDD, LED_K19.VDD, LED_K20.VDD, LED_K21.VDD, LED_K22.VDD, LED_K23.VDD, LED_K24.VDD, LED_K25.VDD, LED_K26.VDD, LED_K27.VDD, LED_K28.VDD; also elsewhere on the board
GND: C57.2, C58.2, C59.2, C61.2, C64.2, C65.2, C66.2, C67.2, C68.2, C69.2, C70.2, C71.2, C72.2, C73.2, C74.2, C75.2, C76.2, C77.2, C78.2, C79.2, C80.2, C82.2, C83.2, C87.2, C88.2, LED_K2.GND (VSS), LED_K3.GND (VSS), LED_K4.GND (VSS), LED_K5.GND (VSS), LED_K6.GND (VSS), LED_K7.GND (VSS), LED_K8.GND (VSS), LED_K9.GND (VSS), LED_K12.GND (VSS), LED_K13.GND (VSS), LED_K14.GND (VSS), LED_K15.GND (VSS), LED_K16.GND (VSS), LED_K17.GND (VSS), LED_K18.GND (VSS), LED_K19.GND (VSS), LED_K20.GND (VSS), LED_K21.GND (VSS), LED_K22.GND (VSS), LED_K23.GND (VSS), LED_K24.GND (VSS), LED_K25.GND (VSS), LED_K26.GND (VSS), LED_K27.GND (VSS), LED_K28.GND (VSS); also elsewhere on the board
unnamed: LED_K5.DO, R30.1
unnamed: LED_K2.DIN (DI), R26.1
unnamed: LED_K2.DO, R27.2
unnamed: LED_K3.DIN (DI), R27.1
unnamed: LED_K3.DO, R28.2
unnamed: LED_K4.DIN (DI), R28.1
unnamed: LED_K4.DO, R29.2
unnamed: LED_K5.DIN (DI), R29.1
unnamed: LED_K13.DIN (DI), R39.1
unnamed: LED_K6.DIN (DI), R30.2
unnamed: LED_K6.DO, R31.2
unnamed: LED_K7.DIN (DI), R31.1
unnamed: LED_K7.DO, R32.2
unnamed: LED_K14.DIN (DI), R40.1
unnamed: LED_K18.DIN (DI), R44.1
unnamed: LED_K19.DIN (DI), R45.1
unnamed: LED_K23.DIN (DI), R49.1
unnamed: LED_K24.DIN (DI), R50.1
unnamed: LED_K13.DO, R40.2
unnamed: LED_K15.DO, R42.1
unnamed: LED_K12.DIN (DI), R38.1
unnamed: LED_K12.DO, R39.2
unnamed: LED_K14.DO, R41.2
unnamed: LED_K18.DO, R45.2
unnamed: LED_K19.DO, R46.2
unnamed: LED_K23.DO, R50.2
unnamed: LED_K24.DO, R59.2
unnamed: LED_K15.DIN (DI), R41.1
unnamed: LED_K20.DO, R47.1
unnamed: LED_K16.DIN (DI), R42.2
unnamed: LED_K16.DO, R43.2
unnamed: LED_K17.DIN (DI), R43.1
unnamed: LED_K17.DO, R44.2
unnamed: LED_K20.DIN (DI), R46.1
unnamed: LED_K25.DIN (DI), R59.1
unnamed: LED_K9.DO, R38.2
unnamed: LED_K8.DIN (DI), R32.1
unnamed: LED_K9.DIN (DI), R35.1
unnamed: LED_K25.DO, R76.1
unnamed: LED_K21.DIN (DI), R47.2
unnamed: LED_K21.DO, R48.2
unnamed: LED_K22.DIN (DI), R48.1
unnamed: LED_K22.DO, R49.2
unnamed: LED_K8.DO, R35.2
unnamed: LED_K26.DIN (DI), R76.2
unnamed: LED_K26.DO, R85.2
unnamed: LED_K27.DIN (DI), R85.1
unnamed: LED_K27.DO, R92.2
unnamed: LED_K28.DIN (DI), R92.1
TIM3_CH2_TOP: R26.2; also elsewhere on the board

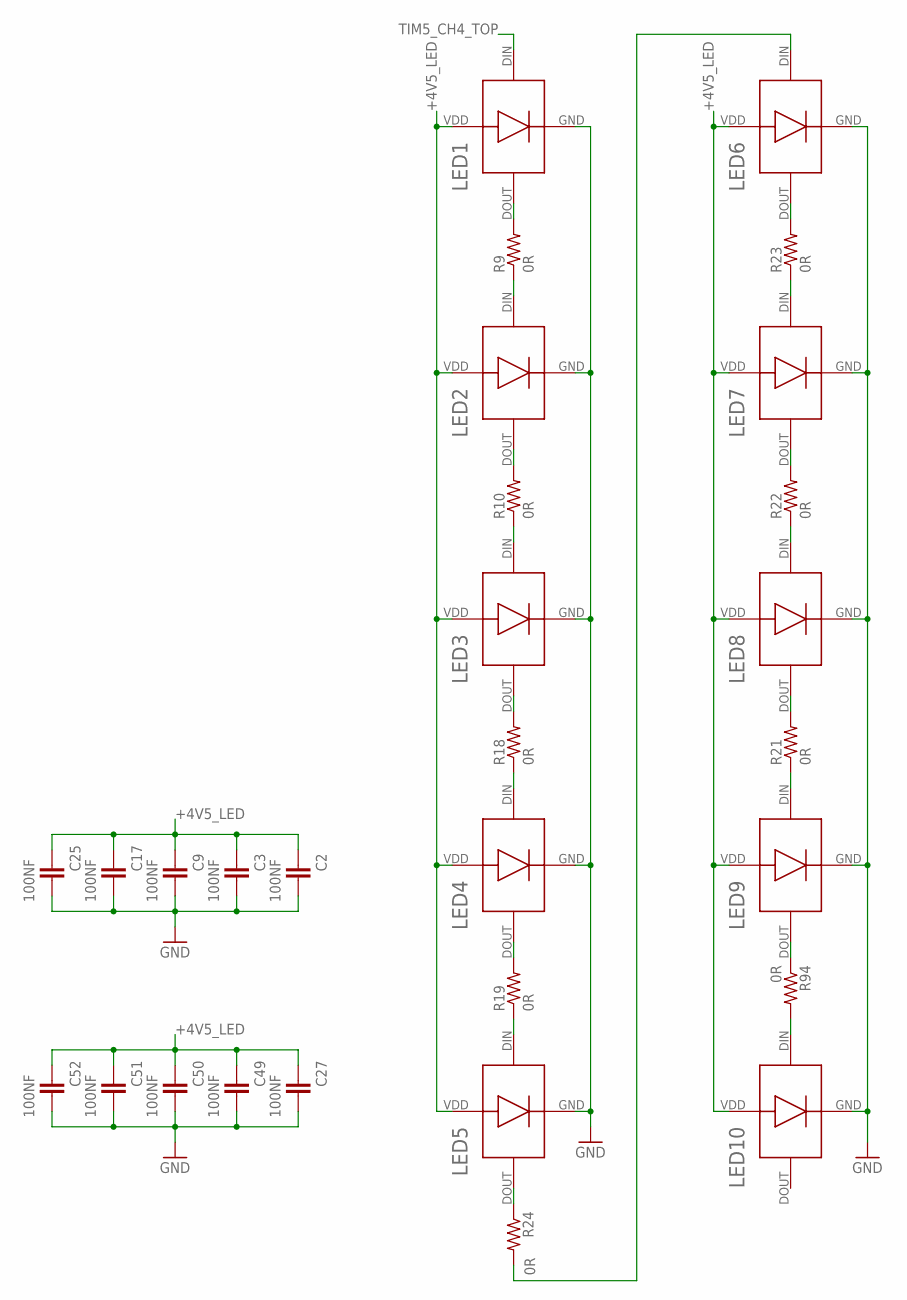
[picture p19: schematic CC_Chompi_Rev4.sch, sheet 5, Top Leds]

Parts:
C2, C3, C9, C17, C25, C27, C49, C50, C51, C52: 100NF; C0402
LED1, LED2, LED4, LED5, LED10: WS2812D-F8
LED3: DIGITAL_LEDWS2812D-F8-SPLIT; WS2812D-F8-SPLIT
LED6, LED7, LED8, LED9: DIGITAL_LEDWS2812D-F5; WS2812D-F5
R9, R10, R18, R19, R21, R22, R23, R24, R94: 0R; R0603

Connections:
+4V5_LED: C2.1, C3.1, C9.1, C17.1, C25.1, C27.1, C49.1, C50.1, C51.1, C52.1, LED1.VDD, LED2.VDD, LED3.VDD, LED4.VDD, LED5.VDD, LED6.VDD, LED7.VDD, LED8.VDD, LED9.VDD, LED10.VDD; also elsewhere on the board
GND: C2.2, C3.2, C9.2, C17.2, C25.2, C27.2, C49.2, C50.2, C51.2, C52.2, LED1.GND (VSS), LED2.GND (VSS), LED3.GND (VSS), LED4.GND (VSS), LED5.GND (VSS), LED6.GND (VSS), LED7.GND (VSS), LED8.GND (VSS), LED9.GND (VSS), LED10.GND (VSS); also elsewhere on the board
unnamed: LED9.DOUT (DO), R94.1
unnamed: LED10.DIN (DI), R94.2
unnamed: LED8.DOUT (DO), R21.2
unnamed: LED5.DOUT (DO), R24.1
unnamed: LED1.DOUT (DO), R9.2
unnamed: LED2.DIN (DI), R9.1
unnamed: LED2.DOUT (DO), R10.2
unnamed: LED3.DIN (DI), R10.1
unnamed: LED3.DOUT (DO), R18.2
unnamed: LED4.DIN (DI), R18.1
unnamed: LED4.DOUT (DO), R19.2
unnamed: LED5.DIN (DI), R19.1
unnamed: LED9.DIN (DI), R21.1
unnamed: LED7.DOUT (DO), R22.2
unnamed: LED8.DIN (DI), R22.1
unnamed: LED6.DOUT (DO), R23.2
unnamed: LED7.DIN (DI), R23.1
unnamed: LED6.DIN (DI), R24.2
TIM5_CH4_TOP: LED1.DIN (DI); also elsewhere on the board
