CHOMPI-Club/CHOMPI/hardware/hardware-pcb/board files/CC_Chompi_Rev4.brd

## EAGLE design hardware/hardware-pcb/board files/CC_Chompi_Rev4.brd (continued)

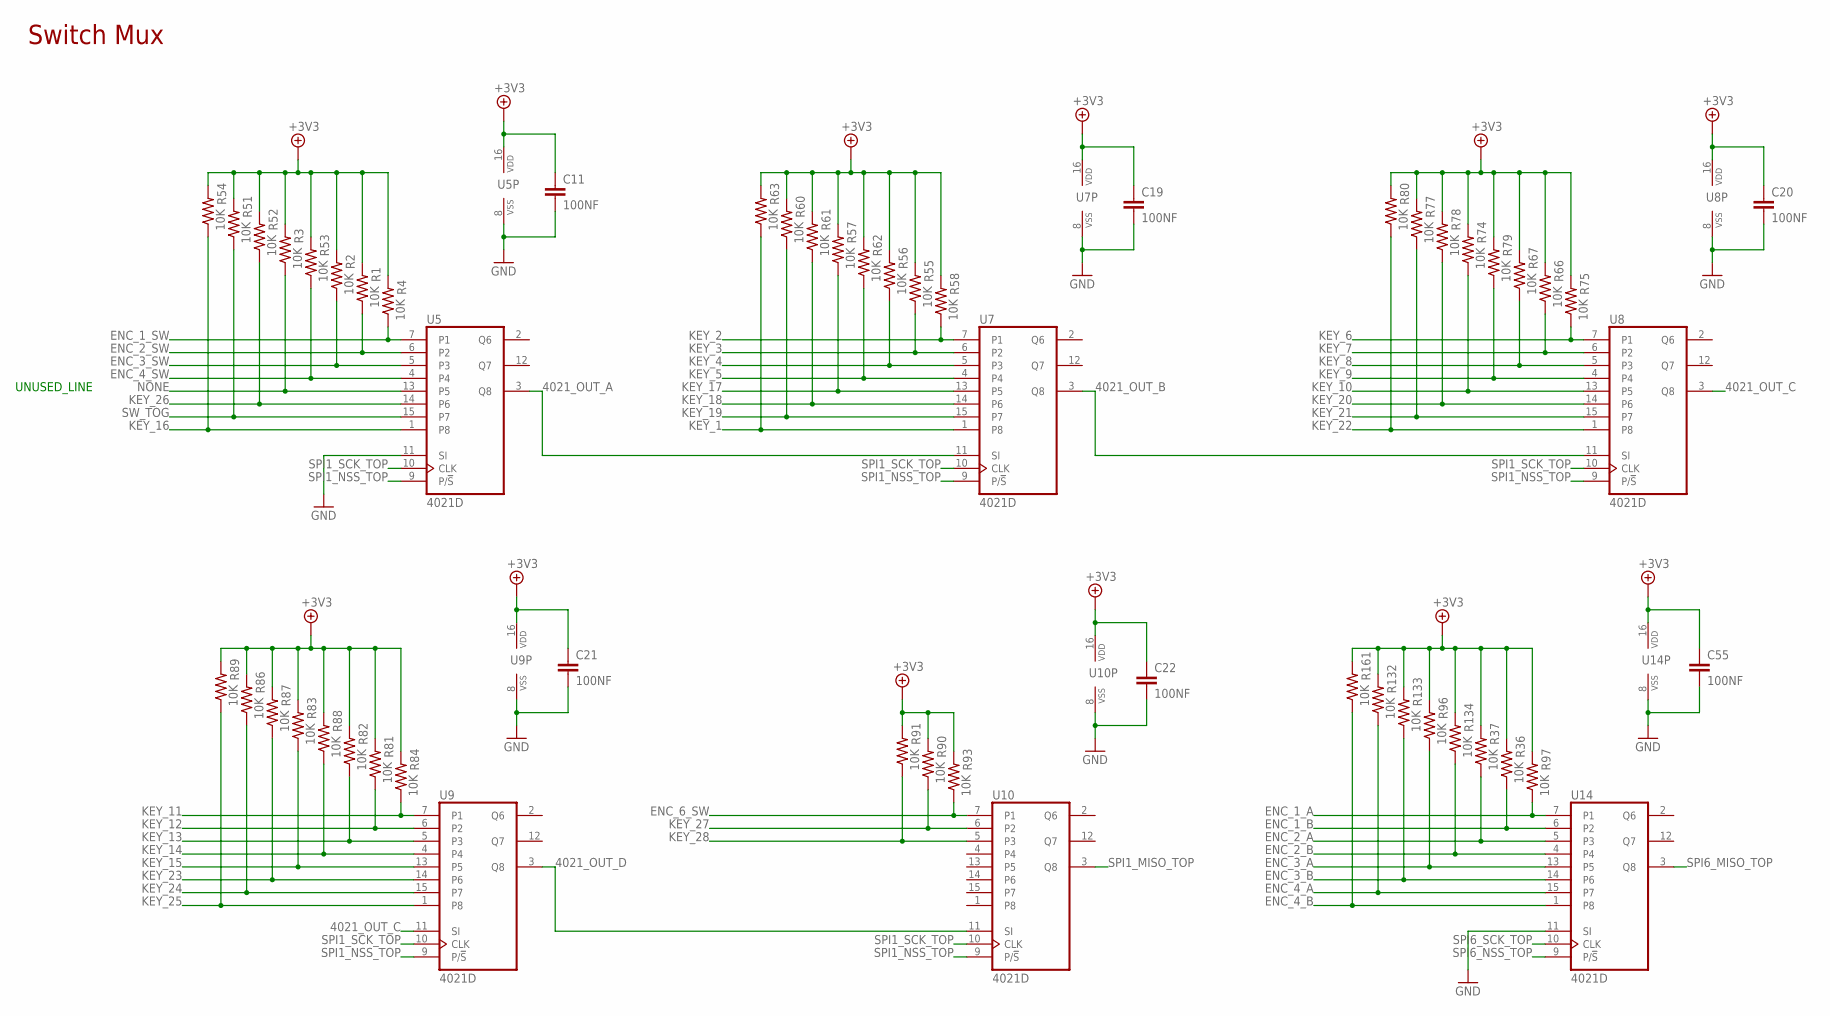
[picture p20: schematic CC_Chompi_Rev4.sch, sheet 6, Switch Mux]

Parts:
C11, C19, C20, C21, C22, C55: 100NF; C0402
R1, R2, R3, R4, R36, R37, R51, R52, R53, R54, R55, R56, R57, R58, R60, R61, R62, R63, R66, R67, R74, R75, R77, R78, R79, R80, R81, R82, R83, R84, R86, R87, R88, R89, R90, R91, R93, R96, R97, R132, R133, R134, R161: 10K; R0603
U5, U7, U8, U9, U10, U14: 4021D; SO-16

Connections:
4021_OUT_A: U5.3 (Q8), U7.11 (SI)
4021_OUT_B: U7.3 (Q8), U8.11 (SI)
4021_OUT_C: U8.3 (Q8), U9.11 (SI)
4021_OUT_D: U9.3 (Q8), U10.11 (SI)
+3V3: C11.1, C19.1, C20.1, C21.1, C22.1, C55.1, R1.2, R2.2, R3.2, R4.2, R36.2, R37.2, R51.2, R52.2, R53.2, R54.2, R55.2, R56.2, R57.2, R58.2, R60.2, R61.2, R62.2, R63.2, R66.2, R67.2, R74.2, R75.2, R77.2, R78.2, R79.2, R80.2, R81.2, R82.2, R83.2, R84.2, R86.2, R87.2, R88.2, R89.2, R90.2, R91.2, R93.2, R96.2, R97.2, R132.2, R133.2, R134.2, R161.2, U5.16 (VDD), U7.16 (VDD), U8.16 (VDD), U9.16 (VDD), U10.16 (VDD), U14.16 (VDD); also elsewhere on the board
ENC_1_A: R97.1, U14.7 (P1); also elsewhere on the board
ENC_1_B: R36.1, U14.6 (P2); also elsewhere on the board
ENC_1_SW: R4.1, U5.7 (P1); also elsewhere on the board
ENC_2_A: R37.1, U14.5 (P3); also elsewhere on the board
ENC_2_B: R134.1, U14.4; also elsewhere on the board
ENC_2_SW: R1.1, U5.6 (P2); also elsewhere on the board
ENC_3_A: R96.1, U14.13 (P5); also elsewhere on the board
ENC_3_B: R133.1, U14.14 (P6); also elsewhere on the board
ENC_3_SW: R2.1, U5.5 (P3); also elsewhere on the board
ENC_4_A: R132.1, U14.15 (P7); also elsewhere on the board
ENC_4_B: R161.1, U14.1 (P8); also elsewhere on the board
ENC_4_SW: R53.1, U5.4; also elsewhere on the board
ENC_6_SW: R93.1, U10.7 (P1); also elsewhere on the board
GND: C11.2, C19.2, C20.2, C21.2, C22.2, C55.2, U5.8 (VSS), U5.11 (SI), U7.8 (VSS), U8.8 (VSS), U9.8 (VSS), U10.8 (VSS), U14.8 (VSS), U14.11 (SI); also elsewhere on the board
KEY_1: R63.1, U7.1 (P8); also elsewhere on the board
KEY_2: R58.1, U7.7 (P1); also elsewhere on the board
KEY_3: R55.1, U7.6 (P2); also elsewhere on the board
KEY_4: R56.1, U7.5 (P3); also elsewhere on the board
KEY_5: R62.1, U7.4; also elsewhere on the board
KEY_6: R75.1, U8.7 (P1); also elsewhere on the board
KEY_7: R66.1, U8.6 (P2); also elsewhere on the board
KEY_8: R67.1, U8.5 (P3); also elsewhere on the board
KEY_9: R79.1, U8.4; also elsewhere on the board
KEY_10: R74.1, U8.13 (P5); also elsewhere on the board
KEY_11: R84.1, U9.7 (P1); also elsewhere on the board
KEY_12: R81.1, U9.6 (P2); also elsewhere on the board
KEY_13: R82.1, U9.5 (P3); also elsewhere on the board
KEY_14: R88.1, U9.4; also elsewhere on the board
KEY_15: R83.1, U9.13 (P5); also elsewhere on the board
KEY_16: R54.1, U5.1 (P8); also elsewhere on the board
KEY_17: R57.1, U7.13 (P5); also elsewhere on the board
KEY_18: R61.1, U7.14 (P6); also elsewhere on the board
KEY_19: R60.1, U7.15 (P7); also elsewhere on the board
KEY_20: R78.1, U8.14 (P6); also elsewhere on the board
KEY_21: R77.1, U8.15 (P7); also elsewhere on the board
KEY_22: R80.1, U8.1 (P8); also elsewhere on the board
KEY_23: R87.1, U9.14 (P6); also elsewhere on the board
KEY_24: R86.1, U9.15 (P7); also elsewhere on the board
KEY_25: R89.1, U9.1 (P8); also elsewhere on the board
KEY_26: R52.1, U5.14 (P6); also elsewhere on the board
KEY_27: R90.1, U10.6 (P2); also elsewhere on the board
KEY_28: R91.1, U10.5 (P3); also elsewhere on the board
NONE: R3.1, U5.13 (P5)
SPI1_MISO_TOP: U10.3 (Q8); also elsewhere on the board
SPI1_NSS_TOP: U5.9 (P/!S), U7.9 (P/!S), U8.9 (P/!S), U9.9 (P/!S), U10.9 (P/!S); also elsewhere on the board
SPI1_SCK_TOP: U5.10 (CLK), U7.10 (CLK), U8.10 (CLK), U9.10 (CLK), U10.10 (CLK); also elsewhere on the board
SPI6_MISO_TOP: U14.3 (Q8); also elsewhere on the board
SPI6_NSS_TOP: U14.9 (P/!S); also elsewhere on the board
SPI6_SCK_TOP: U14.10 (CLK); also elsewhere on the board
SW_TOG: R51.1, U5.15 (P7); also elsewhere on the board

Notes on the sheet:
Switch Mux
UNUSED_LINE

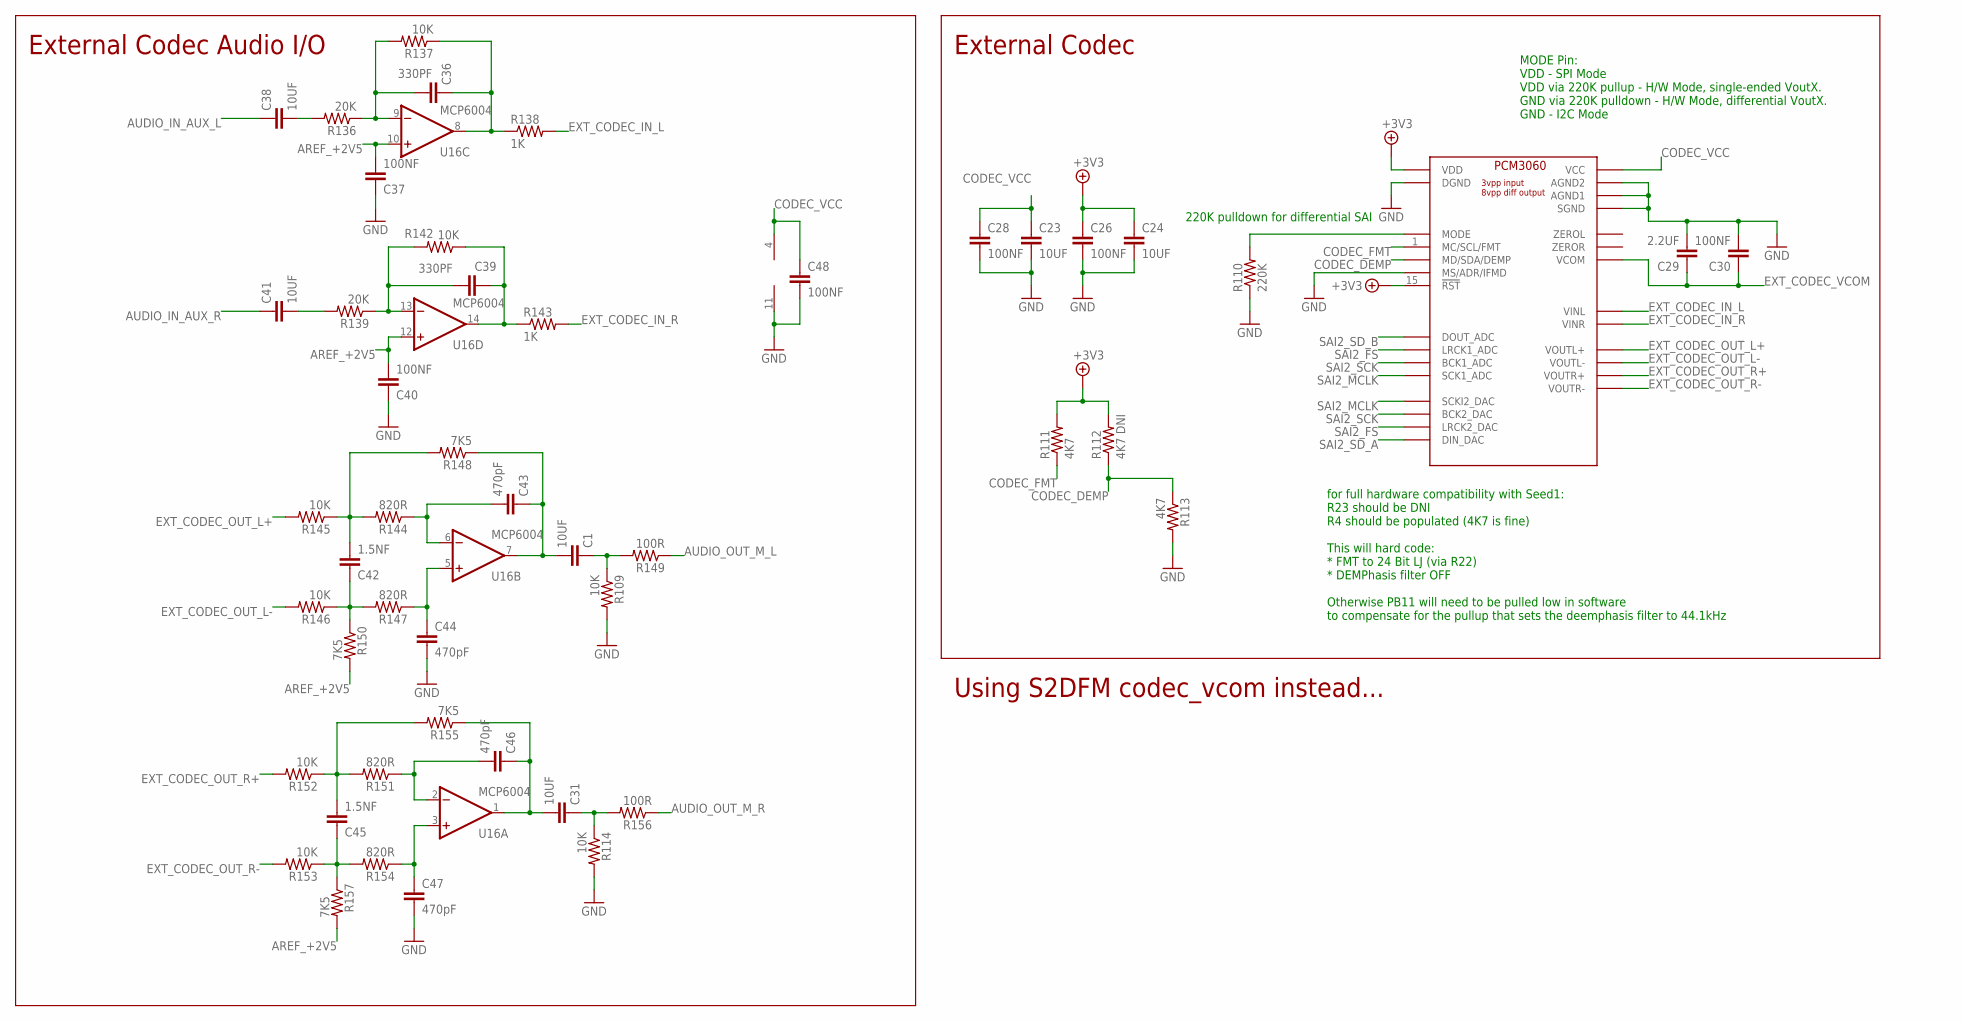
[picture p21: schematic CC_Chompi_Rev4.sch, sheet 7, External Audio]

Parts:
C1, C23, C24, C31, C38, C41: 10UF; C0805
C26, C28, C30, C37, C40, C48: 100NF; C0402
C29: 2.2UF; C0603
C36, C39: 330PF; C0603
C42, C45: 1.5NF; C0603
C43, C44, C46, C47: 470pF; C0603
R109, R114, R137, R142, R145, R146, R152, R153: 10K; R0603
R110: 220K; R0603
R111, R113: 4K7; R0603
R112: 4K7 DNI; R0603
R136, R139: 20K; R0603
R138, R143: 1K; R0402
R144, R147, R151, R154: 820R; R0603
R148, R150, R155, R157: 7K5; R0603
R149, R156: 100R; R0603
U12: PCM3060; TSSOP-28
U16: MCP6004; TSSOP-14

Connections:
+3V3: C24.1, C26.1, R111.2, R112.2, U12.7 (VDD), U12.15 (!RST); also elsewhere on the board
AREF_+2V5: C37.2, C40.2, R150.2, R157.2, U16.10 (+IN), U16.12 (+IN); also elsewhere on the board
AUDIO_IN_AMP_LEFT2: C38.2, R136.2
AUDIO_IN_AUX_L: C38.1; also elsewhere on the board
AUDIO_IN_AUX_R: C41.1; also elsewhere on the board
AUDIO_OUT_M_L: R149.1; also elsewhere on the board
AUDIO_OUT_M_R: R156.1; also elsewhere on the board
CODEC_DEMP: R112.1, R113.1, U12.2 (MD/SDA/DEMP)
CODEC_FMT: R111.1, U12.1 (MC/SCL/FMT)
CODEC_VCC: C23.1, C28.1, C48.1, U12.24 (VCC), U16.4 (V+); also elsewhere on the board
EXT_CODEC_IN_L: R138.2, U12.25 (VINL)
EXT_CODEC_IN_R: R143.2, U12.26 (VINR)
EXT_CODEC_OUT_L+: R145.2, U12.20 (VOUTL+)
EXT_CODEC_OUT_L-: R146.2, U12.19 (VOUTL-)
EXT_CODEC_OUT_R+: R152.2, U12.18 (VOUTR+)
EXT_CODEC_OUT_R-: R153.2, U12.17 (VOUTR-)
EXT_CODEC_VCOM: C29.1, C30.1, U12.21 (VCOM)
GND: C23.2, C24.2, C26.2, C28.2, C29.2, C30.2, C37.1, C40.1, C44.2, C47.2, C48.2, R109.2, R110.1, R113.2, R114.2, U12.8 (DGND), U12.16 (SGND), U12.22 (AGND2), U12.23 (AGND1), U12.27 (MS/ADR/IFMD), U16.11 (V-); also elsewhere on the board
HEADPHONE_IN_L2: C1.2, C43.1, R148.1, U16.7 (OUT)
HEADPHONE_IN_R2: C31.2, C46.1, R155.1, U16.1 (OUT)
unnamed: R110.2, U12.28 (MODE)
unnamed: C1.1, R109.1, R149.2
unnamed: C31.1, R114.1, R156.2
unnamed: C36.1, R137.1, R138.1, U16.8 (OUT)
unnamed: C36.2, R136.1, R137.2, U16.9 (-IN)
unnamed: C39.1, R142.1, R143.1, U16.14 (OUT)
unnamed: C39.2, R139.1, R142.2, U16.13 (-IN)
unnamed: C41.2, R139.2
unnamed: C43.2, R144.1, U16.6 (-IN)
unnamed: C44.1, R147.1, U16.5 (+IN)
unnamed: C42.1, R146.1, R147.2, R150.1
unnamed: C42.2, R144.2, R145.1, R148.2
unnamed: C46.2, R151.1, U16.2 (-IN)
unnamed: C47.1, R154.1, U16.3 (+IN)
unnamed: C45.1, R153.1, R154.2, R157.1
unnamed: C45.2, R151.2, R152.1, R155.2
SAI2_FS: U12.4 (LRCK1_ADC), U12.11 (LRCK2_DAC); also elsewhere on the board
SAI2_MCLK: U12.6 (SCK1_ADC), U12.9 (SCKI2_DAC); also elsewhere on the board
SAI2_SCK: U12.5 (BCK1_ADC), U12.10 (BCK2_DAC); also elsewhere on the board
SAI2_SD_A: U12.12 (DIN_DAC); also elsewhere on the board
SAI2_SD_B: U12.3 (DOUT_ADC); also elsewhere on the board

Notes on the sheet:
External Codec
MODE Pin: VDD - SPI Mode VDD via 220K pullup - H/W Mode, single-ended VoutX. GND via 220K pulldown - H/W Mode, differential VoutX. GND - I2C Mode
220K pulldown for differential SAI
for full hardware compatibility with Seed1: R23 should be DNI R4 should be populated (4K7 is fine) This will hard code: * FMT to 24 Bit LJ (via R22) * DEMPhasis filter OFF Otherwise PB11 will need to be pulled low in software to compensate for the pullup that sets the deemphasis filter to 44.1kHz
External Codec Audio I/O
Using S2DFM codec_vcom instead...

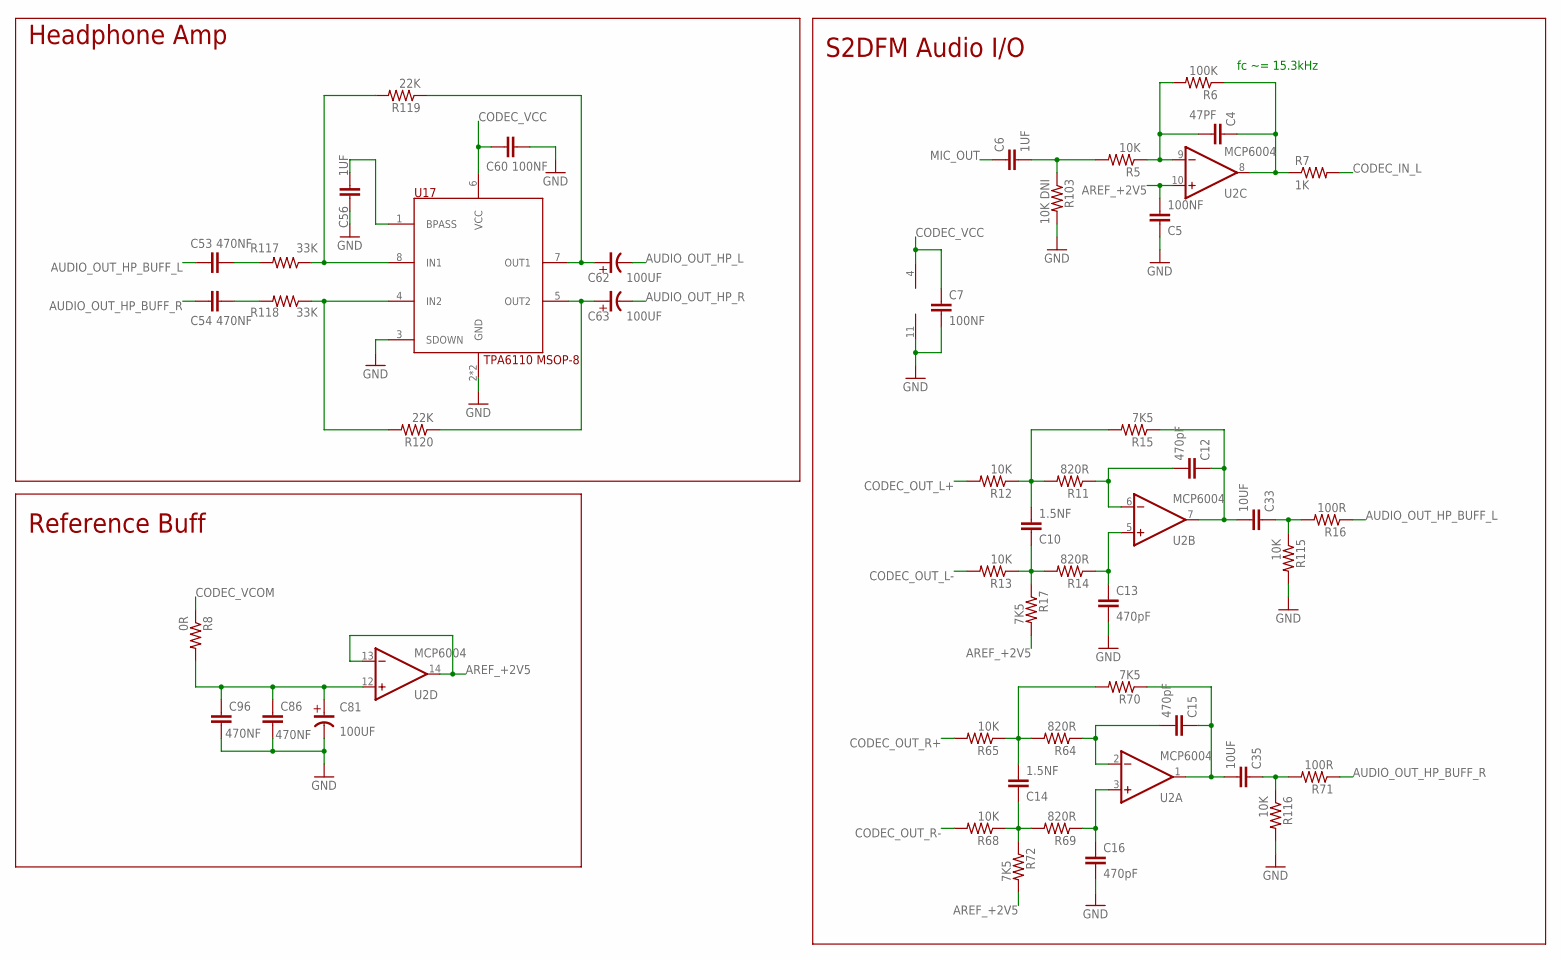
[picture p22: schematic CC_Chompi_Rev4.sch, sheet 8, Internal Audio]

Parts:
C4: 47PF; C0603
C5, C7, C60: 100NF; C0402
C6, C56: 1UF; C0603
C10, C14: 1.5NF; C0603
C12, C13, C15, C16: 470pF; C0603
C33, C35: 10UF; C0805
C53, C54, C86, C96: 470NF; C0603
C62, C63, C81: 100UF; PANASONIC_D
R5, R12, R13, R65, R68, R115, R116: 10K; R0603
R6: 100K; R0402
R7: 1K; R0402
R8: 0R; R0603
R11, R14, R64, R69: 820R; R0603
R15, R17, R70, R72: 7K5; R0603
R16, R71: 100R; R0603
R103: 10K DNI; R0603
R117, R118: 33K; R0603
R119, R120: 22K; R0603
U2: MCP6004; TSSOP-14
U17: TPA6110 MSOP-8; MSOP_8_PWRPAD

Connections:
AREF_+2V5: C5.2, R17.2, R72.2, U2.10 (+IN), U2.13 (-IN), U2.14 (OUT); also elsewhere on the board
AUDIO_IN_AMP_LEFT1: C6.2, R5.2, R103.1
AUDIO_OUT_HP_BUFF_L: C53.1, R16.1
AUDIO_OUT_HP_BUFF_R: C54.1, R71.1
AUDIO_OUT_HP_L: C62.- (NEG); also elsewhere on the board
AUDIO_OUT_HP_R: C63.- (NEG); also elsewhere on the board
CODEC_IN_L: R7.2; also elsewhere on the board
CODEC_OUT_L+: R12.2; also elsewhere on the board
CODEC_OUT_L-: R13.2; also elsewhere on the board
CODEC_OUT_R+: R65.2; also elsewhere on the board
CODEC_OUT_R-: R68.2; also elsewhere on the board
CODEC_VCC: C7.1, C60.2, U2.4 (V+), U17.6 (VCC); also elsewhere on the board
CODEC_VCOM: R8.1; also elsewhere on the board
GND: C5.1, C7.2, C13.2, C16.2, C56.1, C60.1, C81.- (NEG), C86.1, C96.1, R103.2, R115.2, R116.2, U2.11 (V-), U17.2 (GND), U17.3 (SDOWN), U17.9 (GND); also elsewhere on the board
HEADPHONE_IN_L1: C12.1, C33.2, R15.1, U2.7 (OUT)
HEADPHONE_IN_R1: C15.1, C35.2, R70.1, U2.1 (OUT)
MIC_OUT: C6.1; also elsewhere on the board
unnamed: C33.1, R16.2, R115.1
unnamed: C35.1, R71.2, R116.1
unnamed: C53.2, R117.2
unnamed: C54.2, R118.2
unnamed: C4.1, R6.1, R7.1, U2.8 (OUT)
unnamed: C4.2, R5.1, R6.2, U2.9 (-IN)
unnamed: C81.+ (POS), C86.2, C96.2, R8.2, U2.12 (+IN)
unnamed: C12.2, R11.1, U2.6 (-IN)
unnamed: C13.1, R14.1, U2.5 (+IN)
unnamed: R117.1, R119.2, U17.8 (IN1)
unnamed: R118.1, R120.2, U17.4 (IN2)
unnamed: C56.2, U17.1 (BPASS)
unnamed: C10.1, R13.1, R14.2, R17.1
unnamed: C62.+ (POS), R119.1, U17.7 (OUT1)
unnamed: C10.2, R11.2, R12.1, R15.2
unnamed: C15.2, R64.1, U2.2 (-IN)
unnamed: C16.1, R69.1, U2.3 (+IN)
unnamed: C14.1, R68.1, R69.2, R72.1
unnamed: C14.2, R64.2, R65.1, R70.2
unnamed: C63.+ (POS), R120.1, U17.5 (OUT2)

Notes on the sheet:
Headphone Amp
S2DFM Audio I/O
Reference Buff
fc ~= 15.3kHz

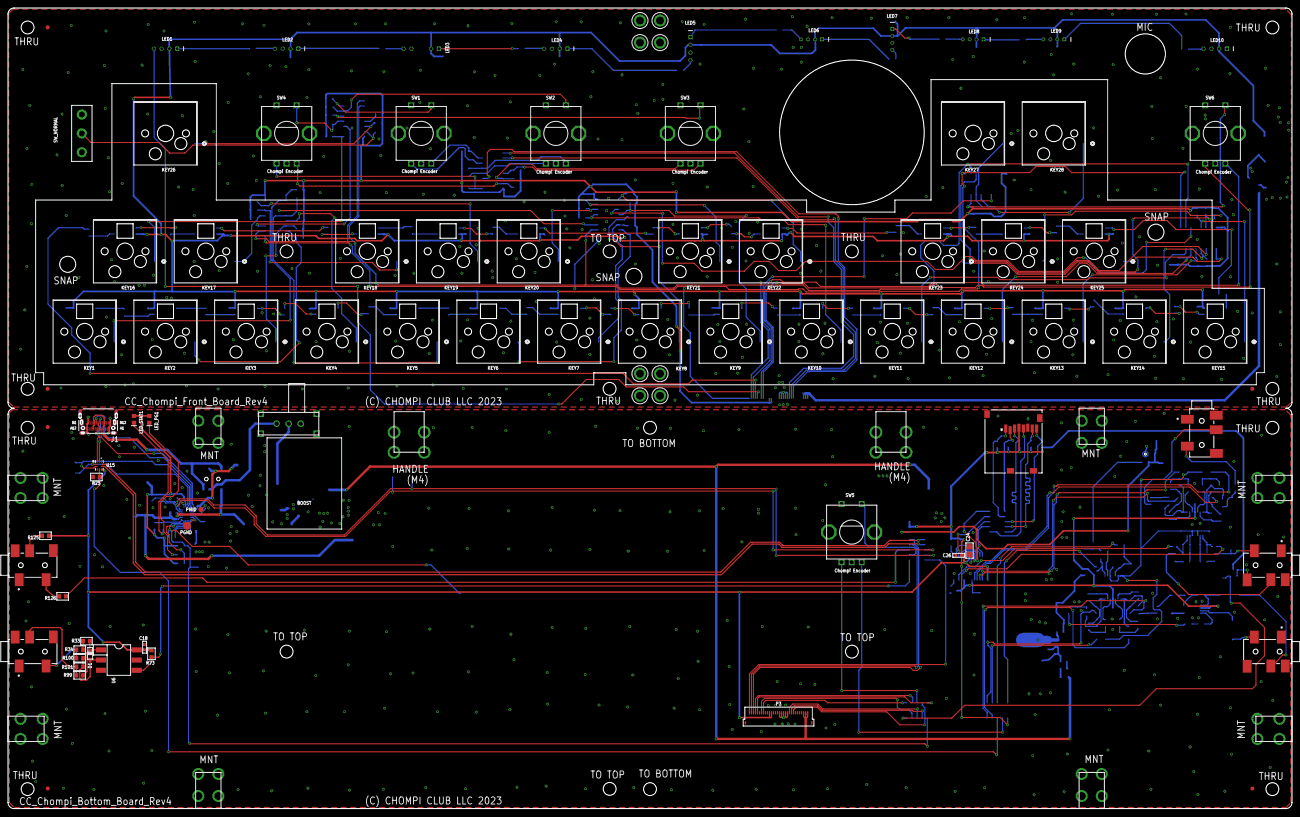
[picture p23: board CC_Chompi_Rev4.brd from above]

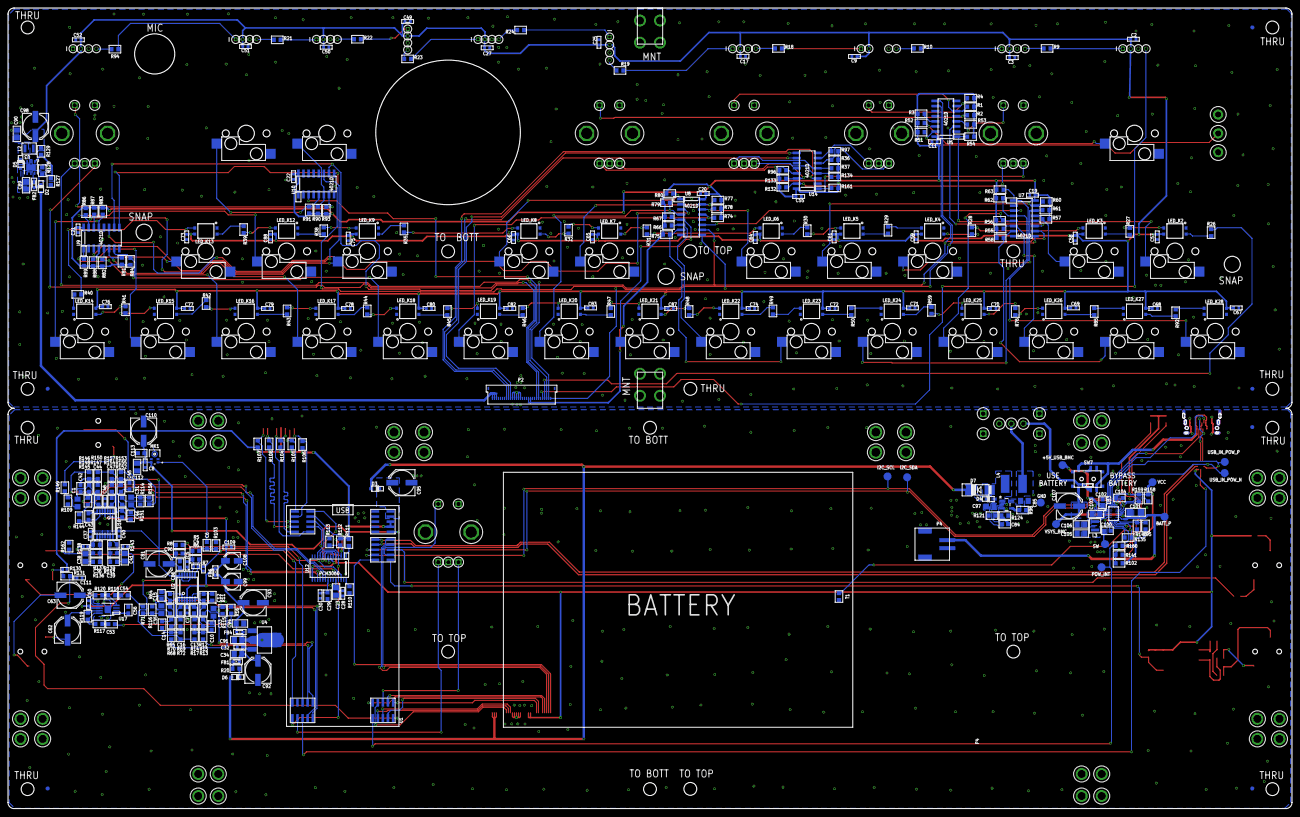
[picture p24: board CC_Chompi_Rev4.brd from below]

Board: 2 copper layers, 319.7 x 199.4 mm, 428 parts (367 on the bottom side), 273 nets.
