CHOMPI-Club/CHOMPI/firmware/chompi-tape/code/src/encoder.h

#pragma once
#ifndef CHOMPI_ENCODER_H
#define CHOMPI_ENCODER_H
#include "daisy_core.h"
#include "hid/switch.h"

namespace chompi
{
/** 
    @brief Generic Class for handling Quadrature Encoders \n 
    Inspired/influenced by Mutable Instruments (pichenettes) Encoder classes
    @author Electrosmith
    @date December 2019
    @ingroup controls
*/
class ChompiEncoder
{
  public:
    ChompiEncoder() {}
    ~ChompiEncoder() {}

    /** Initializes the encoder with the specified hardware pins.
     * Update rate is to be deprecated in a future release
     */
    void Init(dsy_gpio_pin a,
              dsy_gpio_pin b,
              dsy_gpio_pin click,
              float        update_rate = 0.f);
    /** Called at update_rate to debounce and handle timing for the switch.
     * In order for events not to be missed, its important that the Edge/Pressed checks be made at the same rate as the debounce function is being called.
     */
    void Debounce();

    /**
      Just does the A and B based on input states
      For use when your A and B lines are on a SR
    */
    void Debounce(bool a_state, bool b_state);

    /** Returns +1 if the encoder was turned clockwise, -1 if it was turned counter-clockwise, or 0 if it was not just turned. */
    inline int32_t Increment() const { return updated_ ? inc_ : 0; }

    /** Returns true if the encoder was just pressed. */
    inline bool RisingEdge() const { return sw_.RisingEdge(); }

    /** Returns true if the encoder was just released. */
    inline bool FallingEdge() const { return sw_.FallingEdge(); }

    /** Returns true while the encoder is held down.*/
    inline bool Pressed() const { return sw_.Pressed(); }

    /** Returns the time in milliseconds that the encoder has been held down. */
    inline float TimeHeldMs() const { return sw_.TimeHeldMs(); }

    /** To be removed in breaking update
     * \param update_rate Does nothing
    */
    inline void SetUpdateRate(float update_rate) {}

  private:
    uint32_t last_update_;
    bool     updated_;
    daisy::Switch   sw_;
    dsy_gpio hw_a_, hw_b_;
    uint8_t  a_, b_;
    int32_t  inc_;
};
} // namespace chompi
#endif
