CHOMPI-Club/CHOMPI/(notices)

Notices in the files:
parts and their libraries:
Electrosmith-Power: COPYRIGHT: Copyright (C) 2021 Ultra Librarian. All rights reserved.
Electrosmith-Power: COPYRIGHT: Copyright (C) 2023 Ultra Librarian. All rights reserved.
